kkaya674/EE463-TermProject/Demo/20220121_111625.jpg

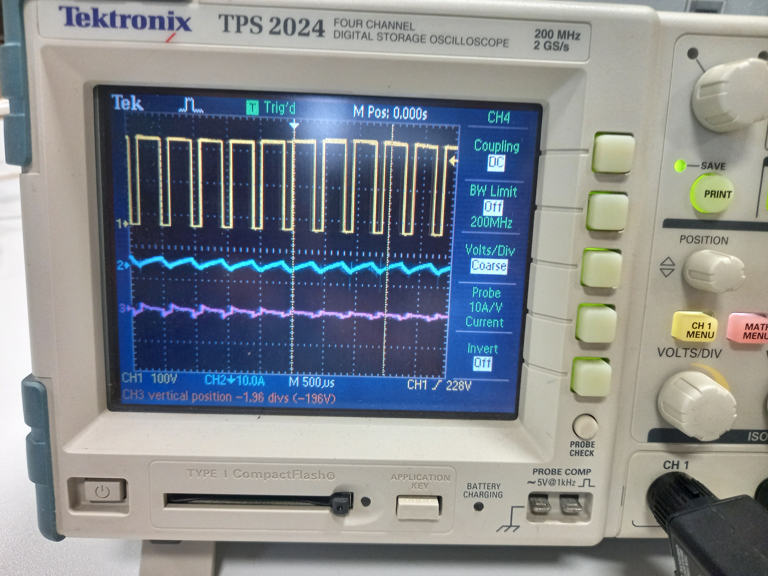
Demo/20220121_111625.jpg
