kkaya674/EE463-TermProject/README.md

# EE463-TermProject
ENJIN DRIVERS: 
Tuğçe Şevval Kaya,
Zehra Güneş, 
Kubilay Kaya

Youtube Video Link : https://www.youtube.com/watch?v=VgHXCVj92XA
