kkaya674/EE463-TermProject/Reports/TermProject Report.docx

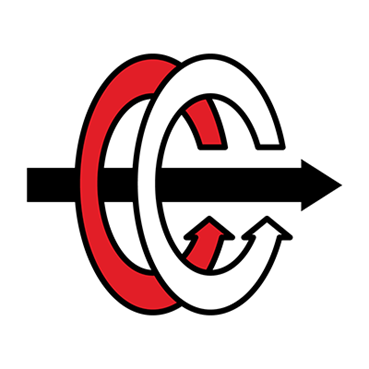
[picture p3: figure]

MIDDLE EAST TECHNICAL UNIVERSITY

DEPARTMENT OF ELECTRICAL & ELECTRONICS ENGINEERING

EE 463- Static Power Conversion I - Hardware Project

DC Motor Drive

Simulation Report

Prepared for Assoc. Prof. Ozan KEYSAN

Tuğçe Şevval Kaya -

Zehra Güneş - 2232023

Kubilay Kaya - 2304905

Table of Contents

Introduction & Specification

# Topology Selection

## Thyristor Rectifiers

### Single Phase Thyristor Rectifiers

#### Advantages

- It contains less circuit elements compared to other topologies.
- Less cost.

#### Disadvantages

- High Ripple Voltage.
- Needs a suitable firing angle. Therefore, controlling the thyristor rectifier is harder than the diode rectifier & buck converter topology.
- In order to minimize the ripple voltage, larger capacitors are needed. Therefore, it leads to unnecessary costs.
- Its true power factor is too small compared to the other topologies since it has higher THD value. THD of input current is not suitable for our applications.
- It is not proper for high voltages.

### Three Phase Thyristor Rectifiers

#### Advantages

- It has less ripple voltage compared to single phase thyristor rectifiers.
- Since the ripple voltage is smaller, the average DC voltage is higher than the single-phase thyristor rectifier.
- It needs a smaller capacitor since the ripple voltage is less.
- Can reach 1.35 times of input line-line voltage.

#### Disadvantages

- More complicated structure.
- The gate control is harder than the single-phase thyristor rectifier.
- It needs more circuit equipment; therefore cost is higher.
- The power factor is still small due to the THD of the input current.

## Three Phase Diode Rectifier & Buck Converters

#### Advantages

- Controlling is easy compared to thyristor rectifiers.
- Using a bridge rectifier, it is more compact.
- Can reach 1.35 times of input line-line voltage.

#### Disadvantages

- In order to minimize inrush current, an inductor should be added to the circuit.
- Its cost is high since the buck converter is the switching equipment. (IGBS, MOSFET etc.)

## Why Diode Rectifier & Buck Converters

We choose 3-phase diode rectifier and buck converter topology in order to drive the DC machine because of these reasons:

- Constructing a diode rectifier is easier than other topologies.
- Constructing a buck converter is cheaper than other topologies since the DC machine already provides the necessary inductor, capacitor, and resistors.
- By using a 555 timer, we can control the buck converter’s switch gate. This is more harder in thyristor rectifiers.

# Analytical Calculation

## Buck Converter Design

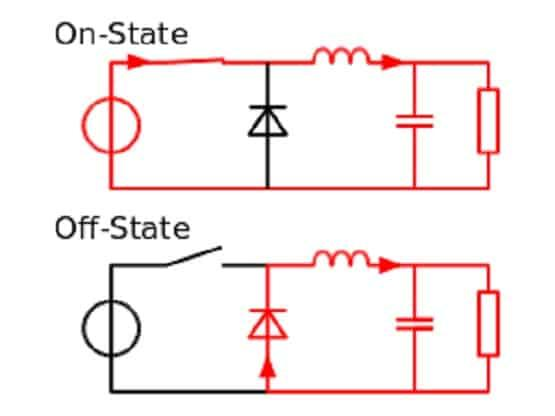
[picture p4: figure]
Buck Converter Nedir, Nasıl Çalışır? - Mühendis Beyinler

Basic circuit model of a buck converter at on and off states in CCM

#### On state

V_d -V_o = V_L and i_c =i_L -(V_o)/R

#### Off state

V_L = -V_o and i_c = -(V_o)/R

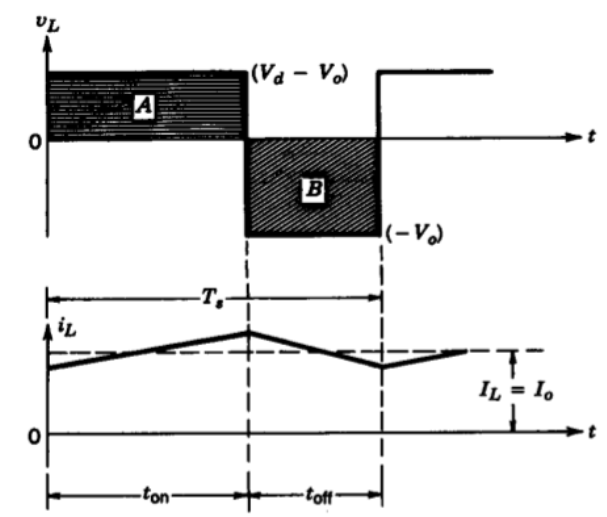
[picture p5: figure]

Voltage and current waveform models of the buck converter

A(ON) (V_(in) -V_o )DT_S =B(OFF) V_o (1-D)T_S

V_(in) D- V_O D=V_o -V_o D

V_o = V_(in) D

0≤ V_o ≤ V_(in) and I_o =(I_d)/D

Since our motor input (Vo) should be smaller than given 180 V maximum level,

180> V_(in) D

Due to nonideal performance conditions, having 1 or 0 duty cycle is not easy to satisfy. Thus,

0.2≤D≤0.8 will be much more valid

Hence, we can define a condition for the input voltage of the buck converter (V_(in) ) as

180/D> V_(in) →180/0.8> V_(in) → V_(in) <225 V

Throughout the function of the buck converter, we also estimated the minimum inductance value to stay in

Continuous Current Mode

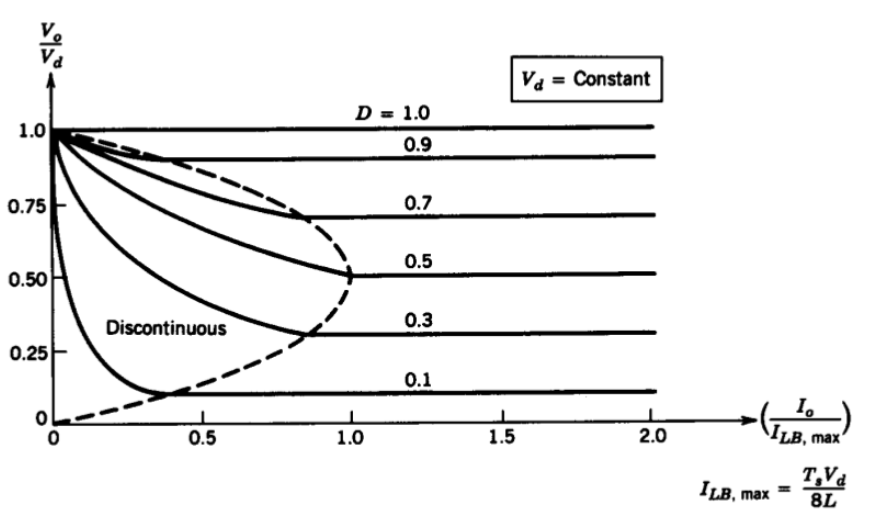
[picture p6: figure]

Output voltage and current relations at Continuous and Discontinuous Conduction Modes

As it can be observed, the critical current value occurs when D = 0.5

Assuming I_(LB) = (i_(L,peak))/2 as I_(LB) = (t_(ON) (V_d -V_o ))/(2L) with t_(ON) =DT_S

Then I_(LB) = (DT_S (V_d -V_o ))/(2L)→ Inserting D=0.5 I_(LB,MAX) = (T_S V_d)/(8L)=(V_d)/(8Lf_S)

also V_o =DV_d

I_(LB) = (DT_S (1-D)V_d)/(2L)= (T_S (1-D)V_O)/(2L) = ((1-D)V_O)/(2Lf_S)

thus, minimum inductance for CCM: L_(min) = ((1-D)V_O)/(2I_(LB) f_S)= ((1-D)Z_(load))/(2f_S)

Foer our case D = 0.5, by given armature impedance of the motor and assuming our frequency range 1-5 kHz it is obtained that

L_(min) = (Z_(load))/(4f_S)≈(0.8Ω)/(4*1000)=0.2 mH

and I_(LB,MAX) =(V_d)/(8Lf_S)=(225 V)/(8*0.2mH*1kHz)<given motor current data=23.4 A

Meaning that throughout our duty cycle choices, even if we do not implement an additional inductor since there is already an inertial inductance of the motor, which is higher than 0.2 mH, we will be in a safe zone for the continuous conduction mode.

#### Voltage Ripple for the Buck Converter

∆Q= ((∆I_L)/2*(T_S)/2)/2=(T_S (∆I_L ))/8

also ∆V_o = (∆Q)/C→ ∆V_o = (T_S (∆I_L ))/(8C)

By using off time ratio (1-D) it is obtained that

∆I_L = (V_o (1-D)T_S)/L since i_L =1/L∫ V_L dt

Then we get ∆V_o = (T_S V_o (1-D)T_S)/(8LC)

and ripple→ (∆V_o)/(V_o)=((1-D)T_S^2)/(8LC)= ((1-D))/(8LCf_S^2)

For worst case scenario, by taking as D=0.2, f_S =1kHz, L=12. 5 mH by only armature

Ripple ≈ 0.8/(8*12.5mH*1000^2 *C)=(8 x 10^(-6))/C

At this point, increasing the frequency or implementing an extremely high capacitor would have been expected as possible solutions. However, increasing the frequency means also increasing the switching losses, which can be found in the thermal analysis part, and it can disturb the thermal limit of our components. Moreover, a small capacitance will not be enough to obtain a reasonable ripple range, much higher value can balance that, yet this will cause higher cost and sizes in our design which may not be applicable under experimental conditions. Thus, it is currently considered that the internal capacitance of the motor will satisfy our conditions. Besides, if it seems necessary during test periods, by choosing 3.3 µF capacitor will be placed.

Hence the ripple is obtained as

(8 x 10^(-6))/C→(8 x 10^(-6))/(3.3 x 10^(-6)) ≅2.42 V

which can be accepted as small in the range of our motor input.

## Rectifier Design

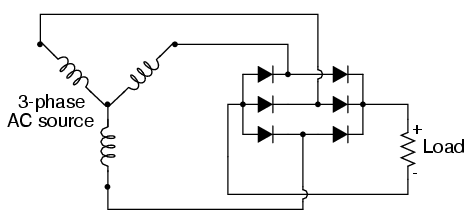
[picture p7: figure]
LM74670-SQEVM: Three phase bridge rectifier design contains large spikes on output - Power management forum - Power management - TI E2E support forums

The circuit connection model of three phase full bridge rectifier design

As it was found previously on the buck converter design part that

V_(in) <225 V for the motor

Since the input voltage of the buck converter is supplied by the output voltage of the rectifier,

V_(out) <225 V for the rectifier

By Yn configuration, the necessary input voltage for the rectifier can be estimated as

V_(out) = (3√2)/πV_(l-l) <225 V→V_(l-l) <(225*π)/(3√2) ≅166.6 V

and V_(in,phase) =166.6/(√3) V

## 555 Timer Calculations

Basic 555 timer structure,

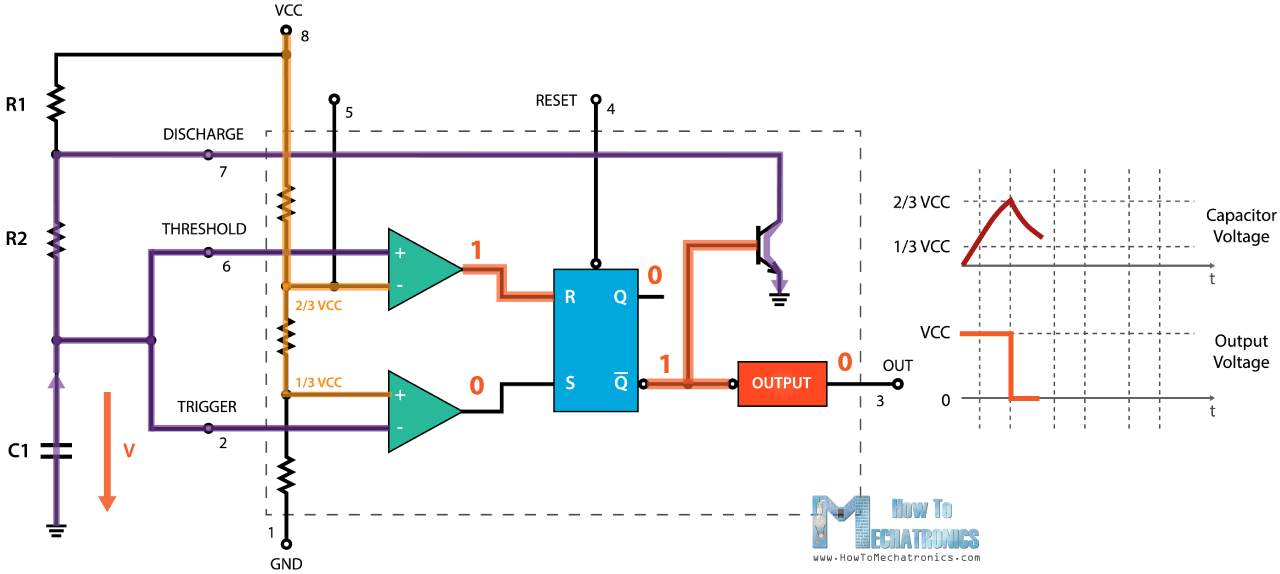
[picture p8: figure]

Formulas,

T_(on) =0.693*(R_1 +R_2 )*C_1

T_(of) =0.693*R_2 *C_1

T_(total) =0.693*(R_1 +2R_2 )*C_1

f=1/(0.693*(R_1 +2R_2 )*C_1 )

PWM(%)=(T_(on))/(T_(total))=((R_1 +R_2 ))/((R_1 +2R_2 ))*100

In order to create adjustable PWM, we add this configuration to the diodes and POTs via the charging and discharging paths.

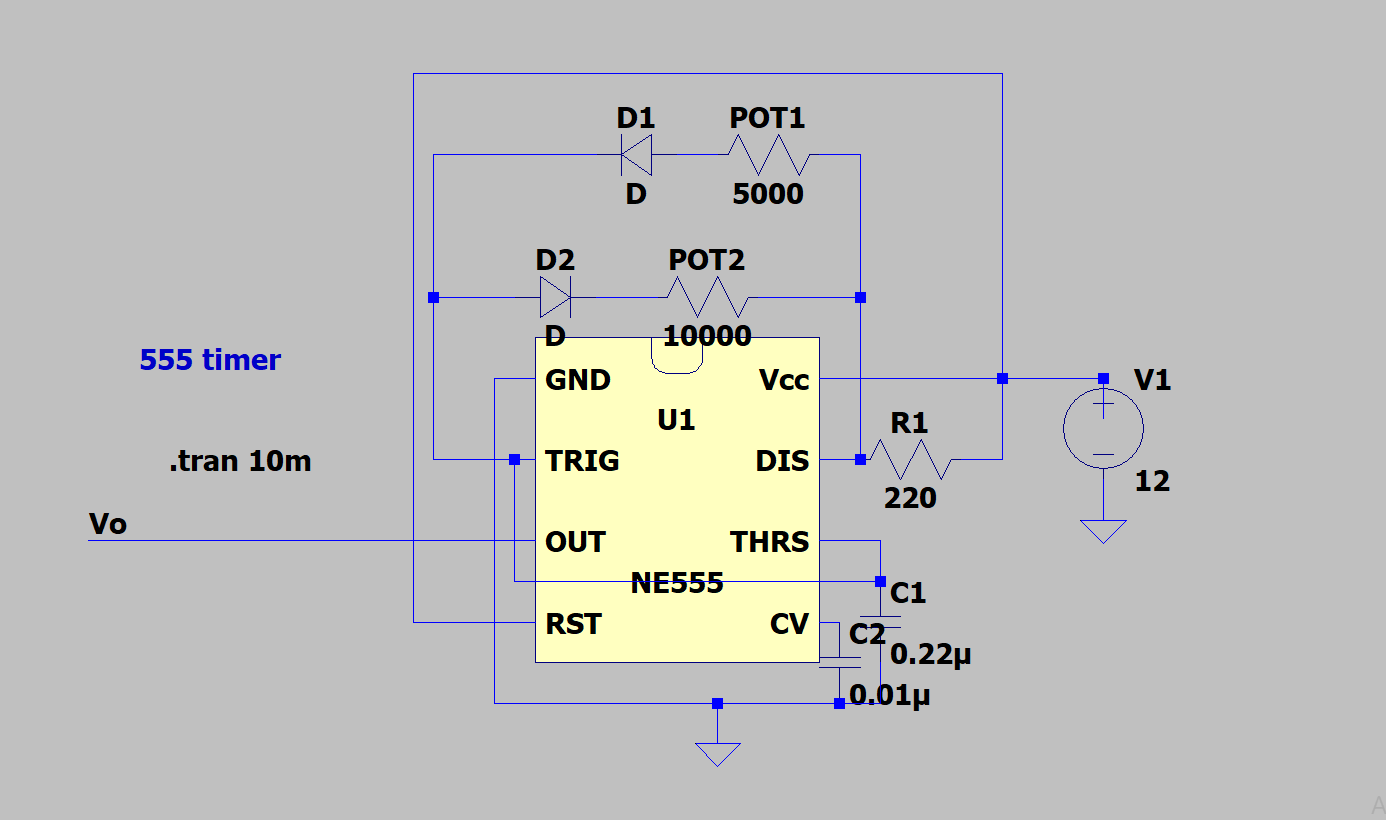
[picture p9: figure]

Calculations,

T_(on) =0.693*(R_(POT1) +R_1 )*C_1

T_(of) =0.693*(R_(POT2) +R_1 )*C_1

T_(total) =0.693*(R_(POT1) +R_(POT2) +2R_1 )*C_1

f=1/(0.693*(R_(POT1) +R_(POT2) +2R_1 )*C_1 )

PWM(%)=(T_(on))/(T_(total))=(R_(POT1) +R_1)/(R_(POT1) +R_(POT2) +2R_1)*100

We have used 5kΩ and 10kΩ resistance respectively for POT1 and POT2. In real, POT1 is changing between 1.6Ω and 4.8k Ω and POT2 is changing between 2.8Ω and 9.6kΩ. Then,

PWM maximum,

T_(on) =0.693*(4.8kΩ+220Ω)*0.22*10^(-6) =0.795ms

T_(of) =0.693*(2.8+220Ω)*0.22*10^(-6) =0.034ms

f=1.19kHz

PWM(%)= 98%

PWM minimum,

T_(on) =0.693*(1.6Ω+220Ω)*0.22*10^(-6) =0.0337ms

T_(of) =0.693*(4.8k+220Ω)*0.22*10^(-6) =1.558ms

f=628Hz

PWM(%)= 2.1%

Although we could reach these PWM values, we have to stay away from the boundary points of PWM. This is because at the near 0% and 100% PWM values, the switch (IGBT) cannot be operated properly since it has a switching time interval of ON and OFF times, PWM is not enough to compensate for it. Therefore, we changed R1 with 1kΩ and we have adjusted PWM between 17% and 85%. By the same steps,

PWM maximum,

T_(on) =0.884ms

T_(on) =0.152ms

f=965Hz

PWM(%)= 85%

PWM minimum,

T_(on) =0.152ms

T_(on) =0.884ms

f=965Hz

PWM(%)= 17%

As seen from obtained results, the operating frequency is around 1kHz, so we decide to use IGBT as a switch. The performance of IGBT is greater than MOSFETs and other switches at low frequencies. Also, the current rating of IGBTs can reach up to 1kA.

# Simulation

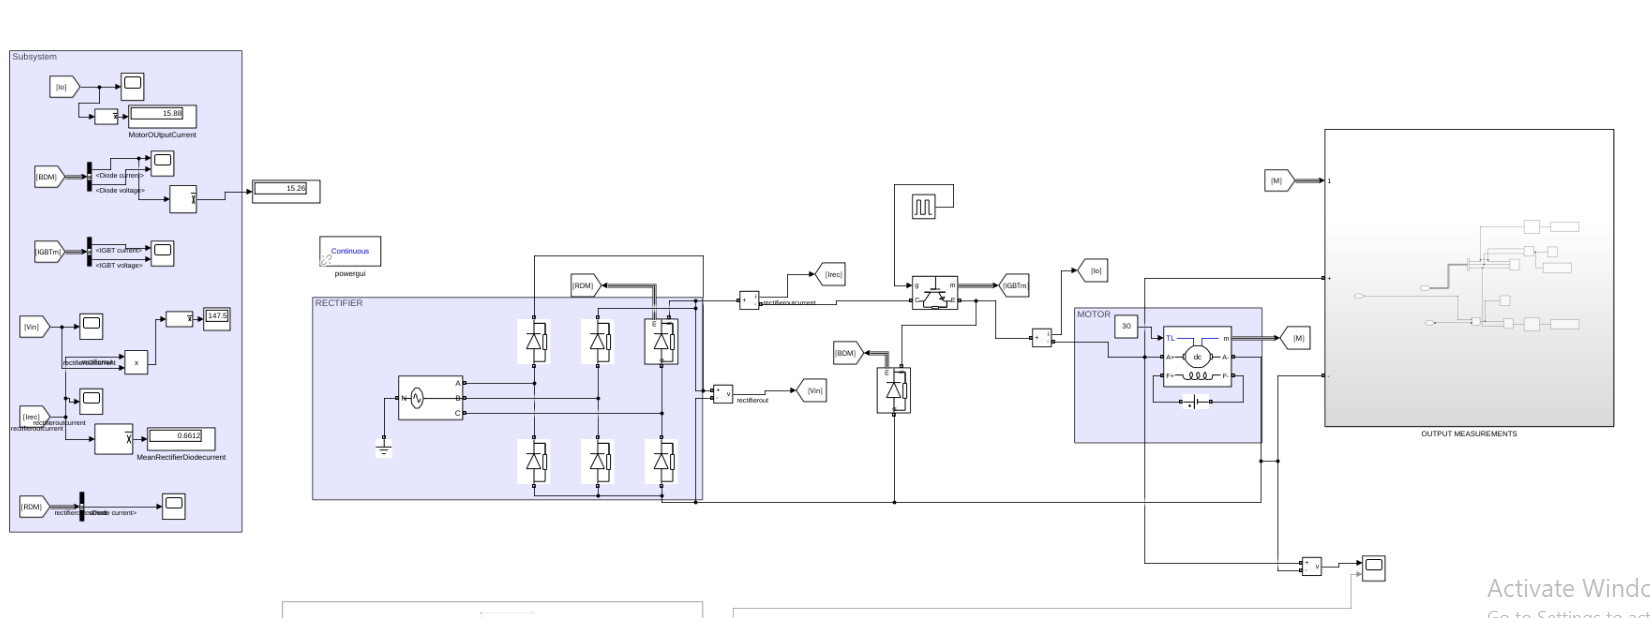
[picture p10: figure]

## 3-Phase Diode Rectifier:

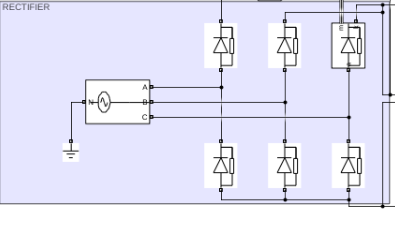
[picture p11: figure]

Rectifier diode current and voltage waveforms,

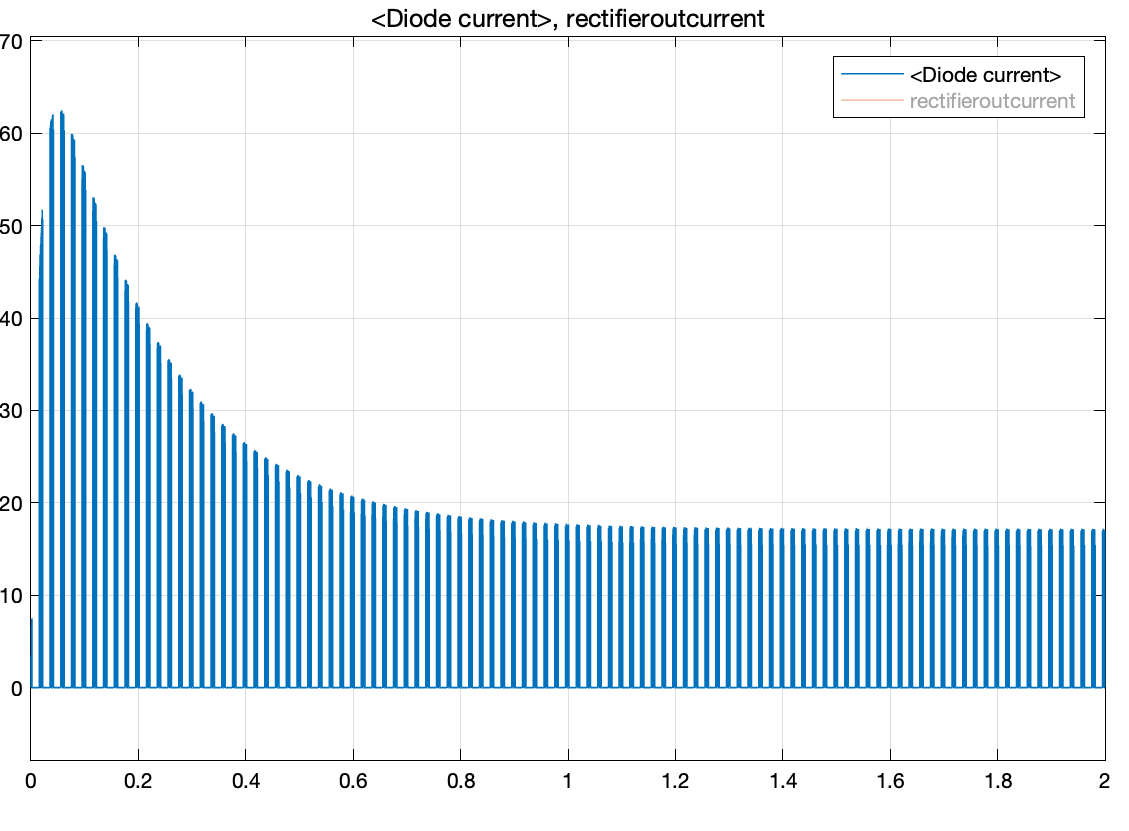
[picture p12: figure]

The graph which can be seen above shows the diode’s starting current if we set the initial duty cycle as 0.2. However, since we don’t know the line impedance, we didn’t add any value to our simulation. Therefore, we expect that less inrush current will be measured in laboratory conditions. Another factor of high starting current is the stationary motor. When the motor is stationary, armature voltage is equal to zero. Then, when we supply voltage to the DC machine, the high current is passing thoruogh armatures. This becomes very problematic since it can damage the circuit. Therefore, we still try to stabilize the armature current for soft-starting.

## A555 Controller

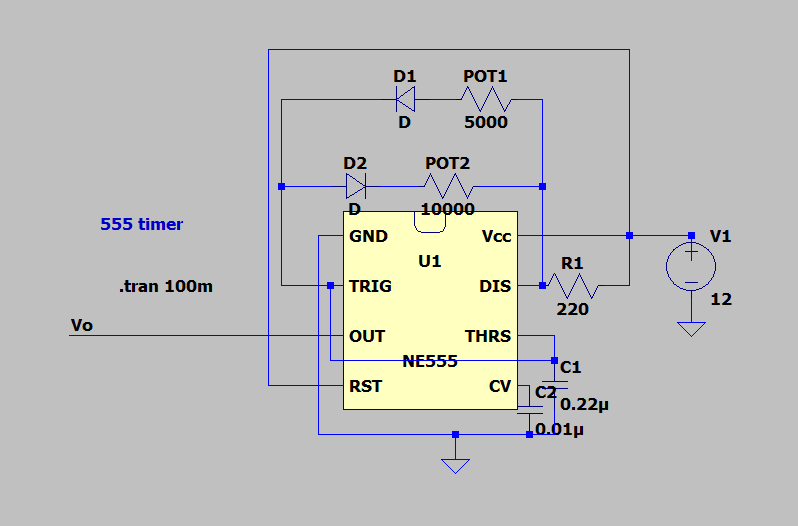
[picture p13: figure]

Maximum duty cycle case,

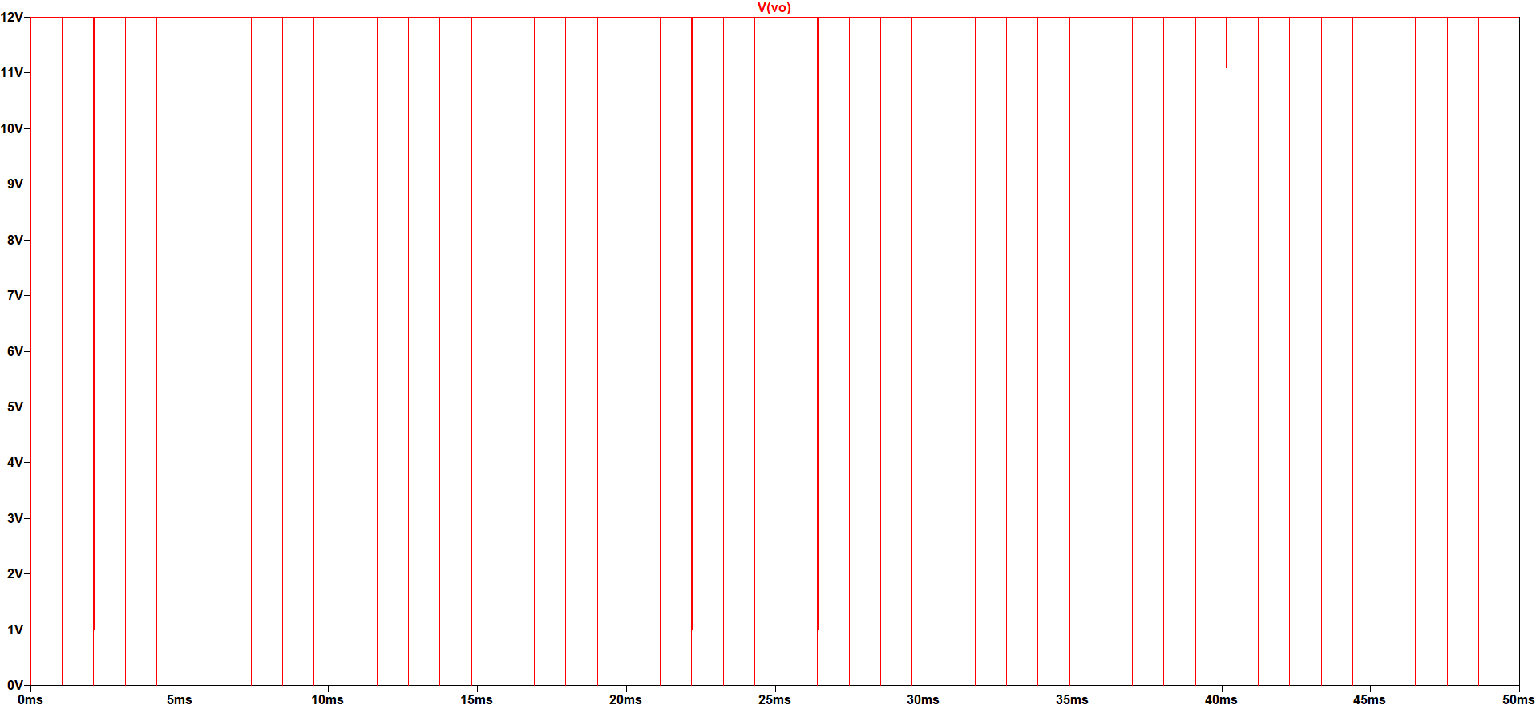
[picture p14: figure]

Minimum duty cycle case,

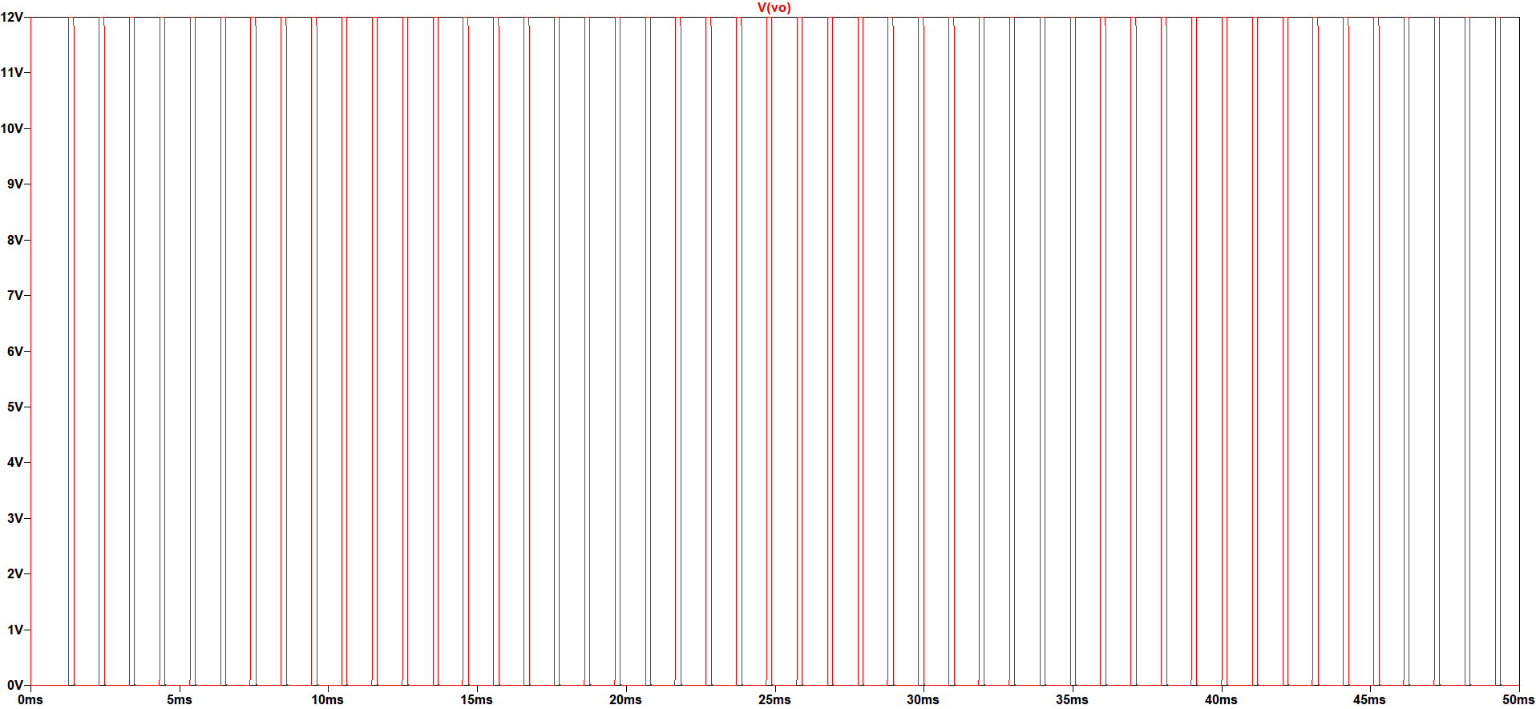
[picture p15: figure]

According to our research, we see that the most convenient way to control the buck converter is using the ASTABLE 555 Timer circuit. An Astable timer can be controlled just by using POTs.

The most crucial advantage of this timer is changing duty cycle easily. However, the frequency changes according to the resistor values that we change. Therefore, it may be a disadvantage. On the other hand, we are using an IGBT for buck converter and it is proper for the 1-5kHz interval. Therefore, we calculated the resistance of the timer to work between these frequency intervals.

In the timer circuit above, R1 & R2 values determine the frequency and the duty cycle of the circuit. We are planning to change both R1 & R2 during our project. The related formulations and description can be seen in the “Analytical Calculation” part.

## Buck Converter

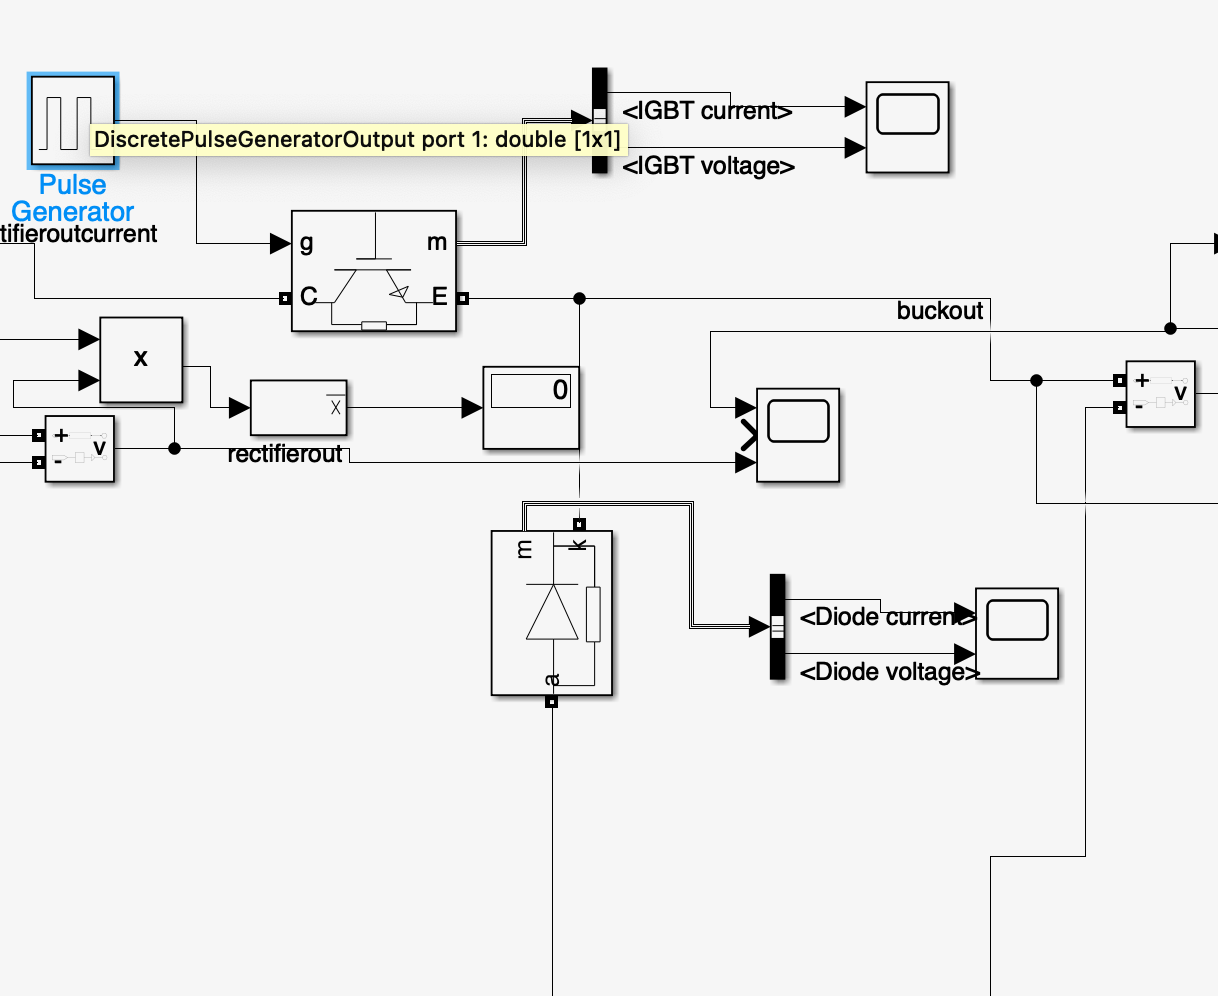
[picture p16: figure]

Here we see the buck converter part. As can be seen, we didn’t connect any capacitor, inductor, and resistance because the DC motor already provides these components’ characteristics. On the other hand, in case of any necessities, we also bought some capacitors to provide better dc voltage at the input terminal of the DC machine.

#### IGBT

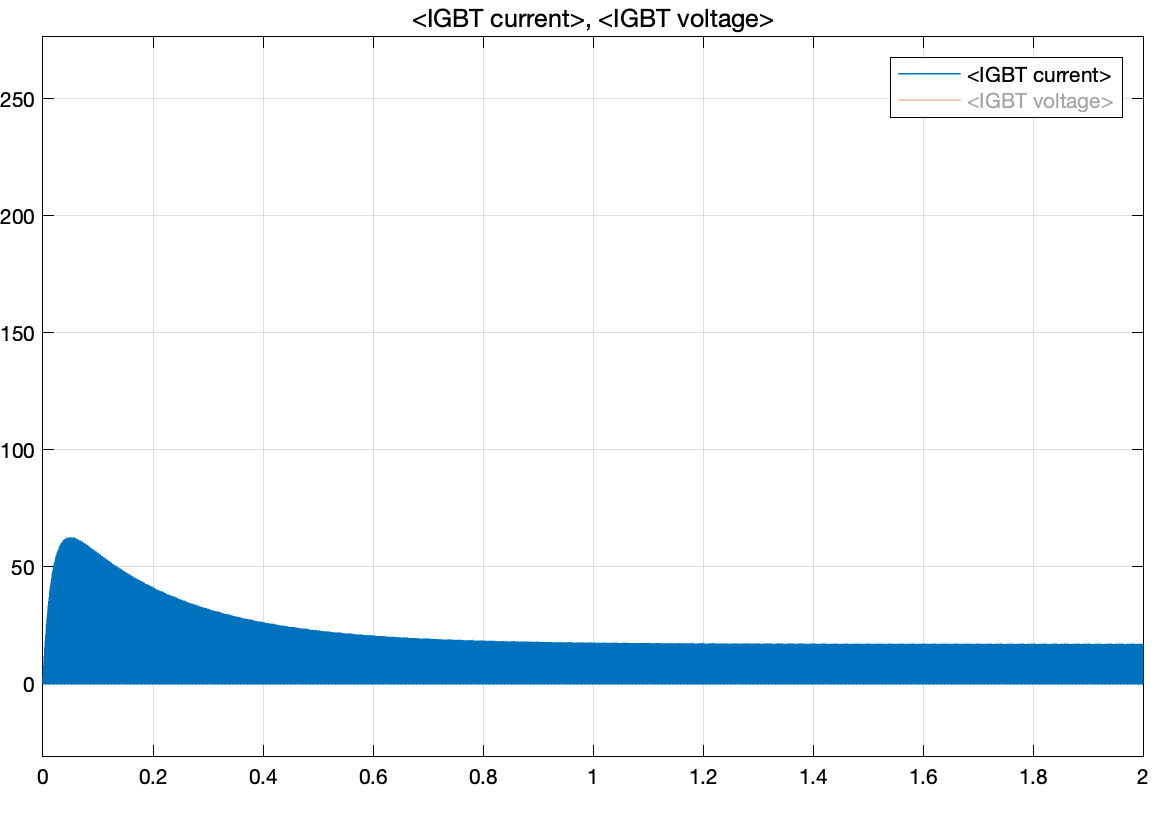
[picture p17: figure]
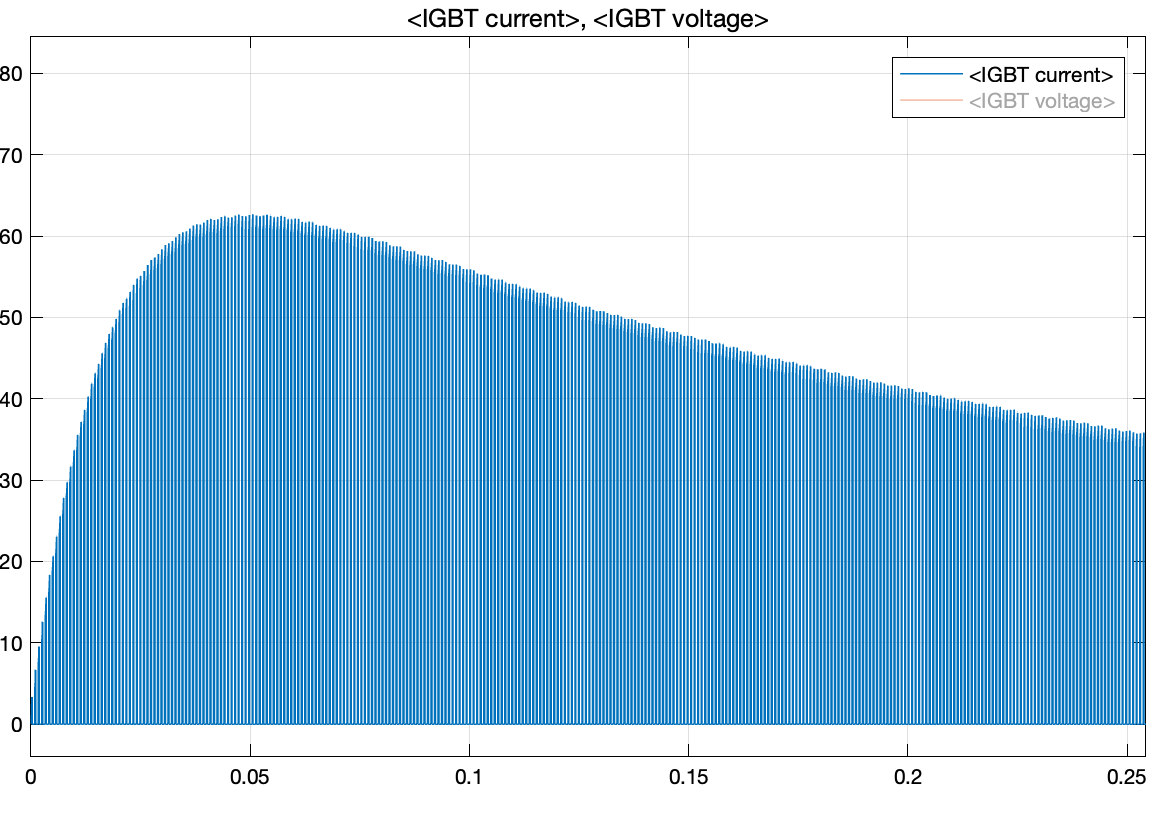
[picture p18: figure]
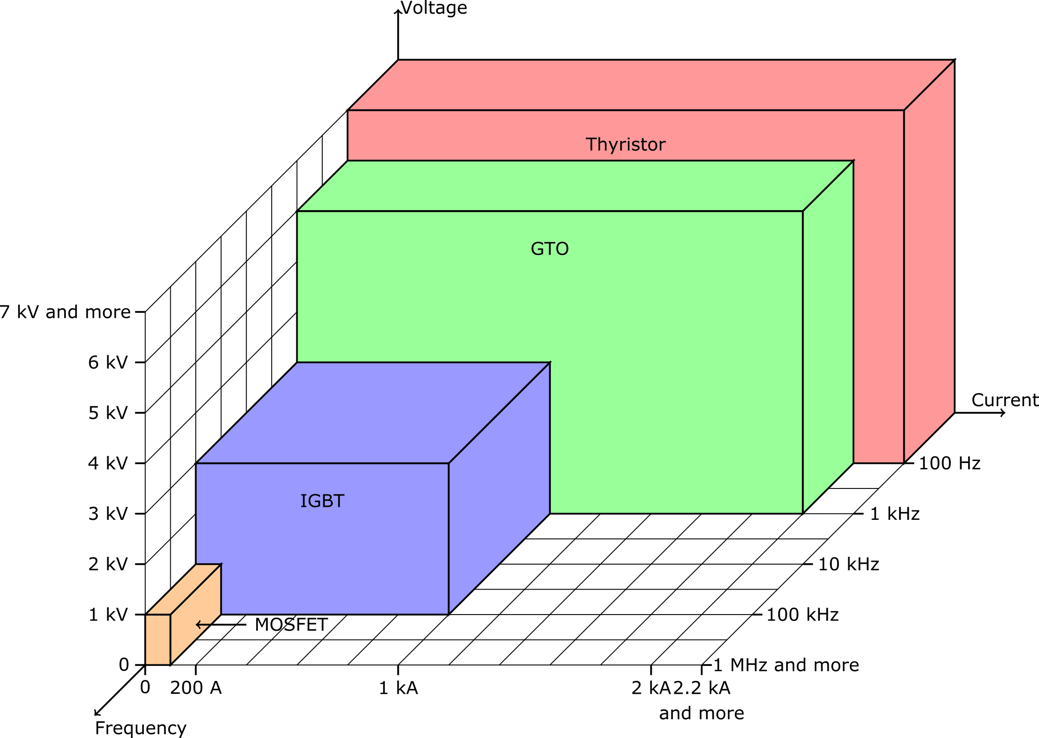
[picture p19: figure]

In our design, we did a selection between MOSFET and IGBT. Since IGBT can work at low frequency and operates at high current values, we choose the IGBT as a switching device. Above, the steady state and starting currents of IGBT for 0.2 duty cycle can be seen. As can be seen, the starting current is relatively high. However, as mentioned in previous parts, we didn’t add any inductor to the source side. Therefore, the inrush current at start up occurs. Also, in this case, the motor’s initial speed is zero. During the demo, since we set an initial voltage by using variac, we expect that this high current will not occur, and we will not observe any problem.

#### Gate Driver

By using a gate driver we have tried to operate IGBT properly without exceeding rating values. When we do not use a gate driver, the gate-emitter value can reach very high values. However, the rating value of gate-emitteer voltage is about 20V for most IGBTs. Therfore, the gate driver provides the same duty cycle to the IGBT by keeping it in a safe region.

Design schematic of gate driver,

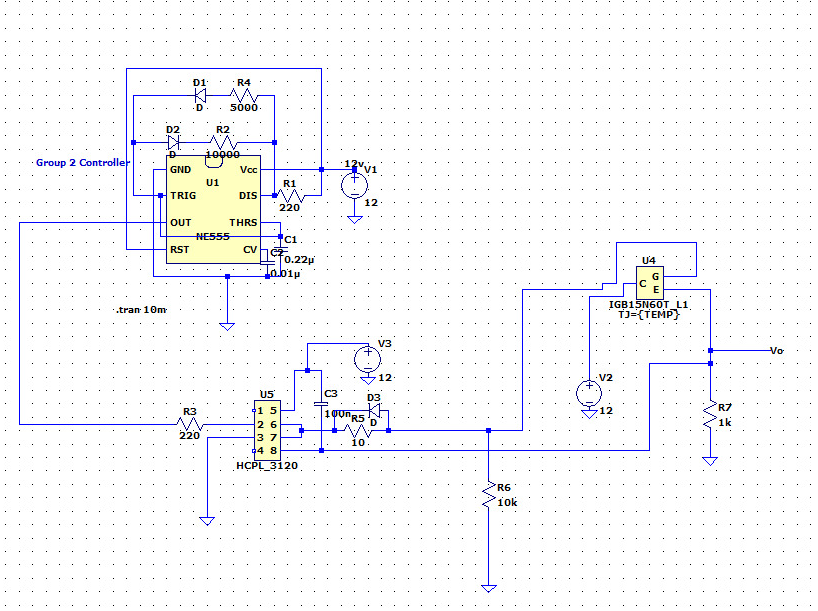
[picture p20: figure]

Output pwm obtained from 555 timer,

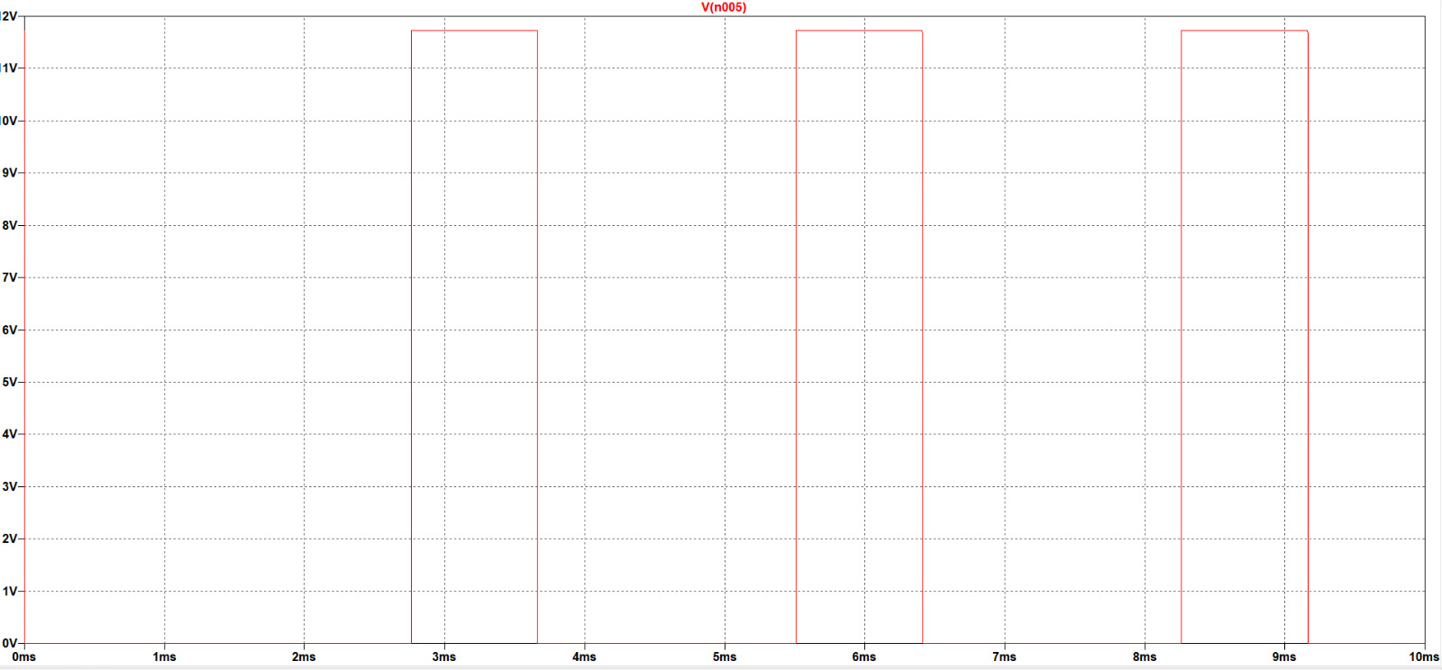
[picture p21: figure]

Output emitter voltage of IGBT,

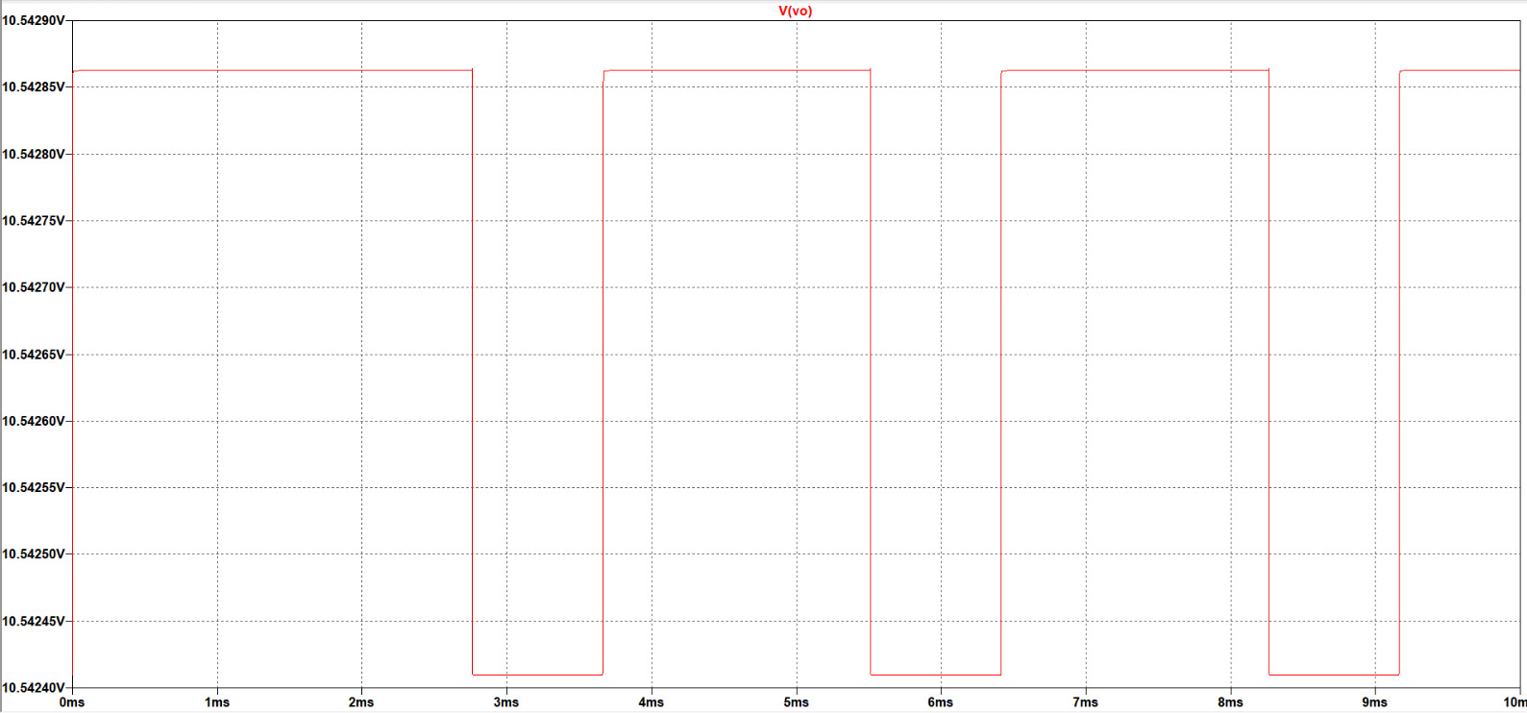
[picture p22: figure]

As seen from the figures, output voltage is a complement of PWM. In order to solve this problem, we decided to add the transistor to the input of the gate driver(pin 1 and 2). The transistor behaves like an inverter and when PWM is high, it gives output low and vice versa. Therefore, input PWM is inverted by transistor and output emitter voltage has a similar shape with the PWM obtained by 555 timer.

#### Buck-Converter Diode

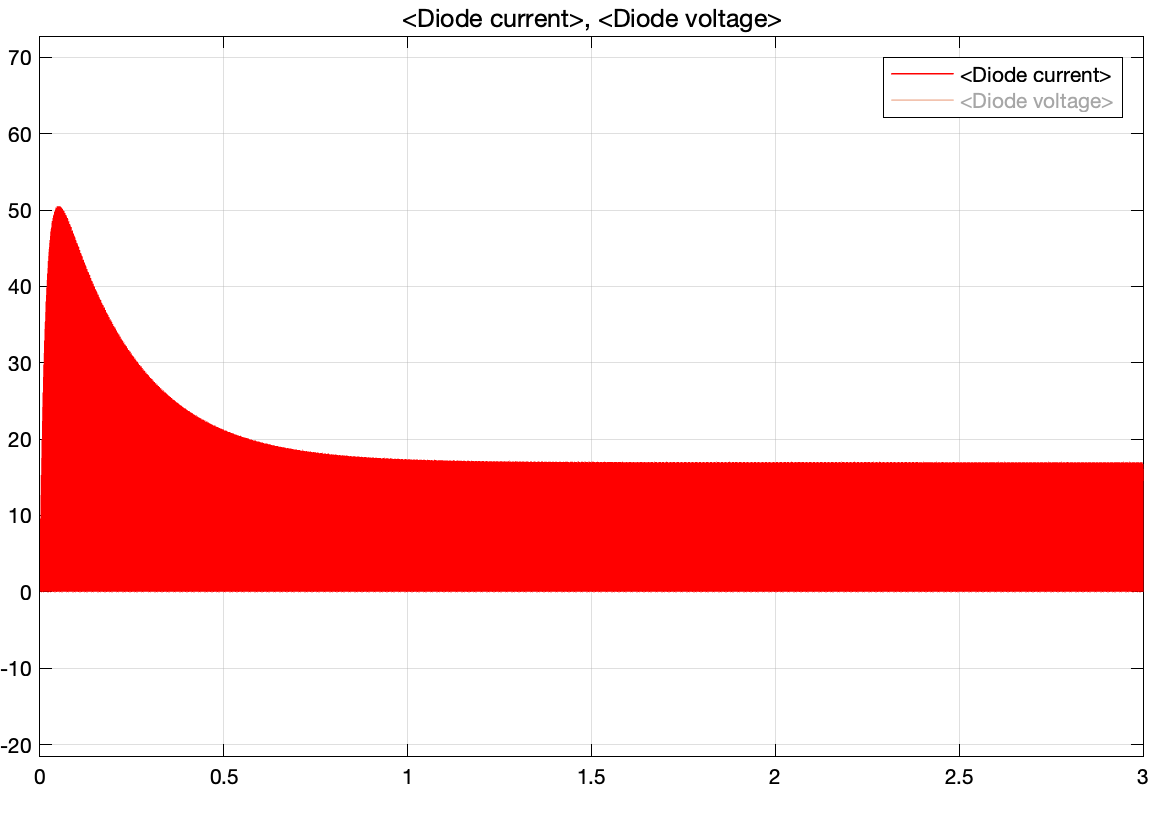
[picture p23: figure]
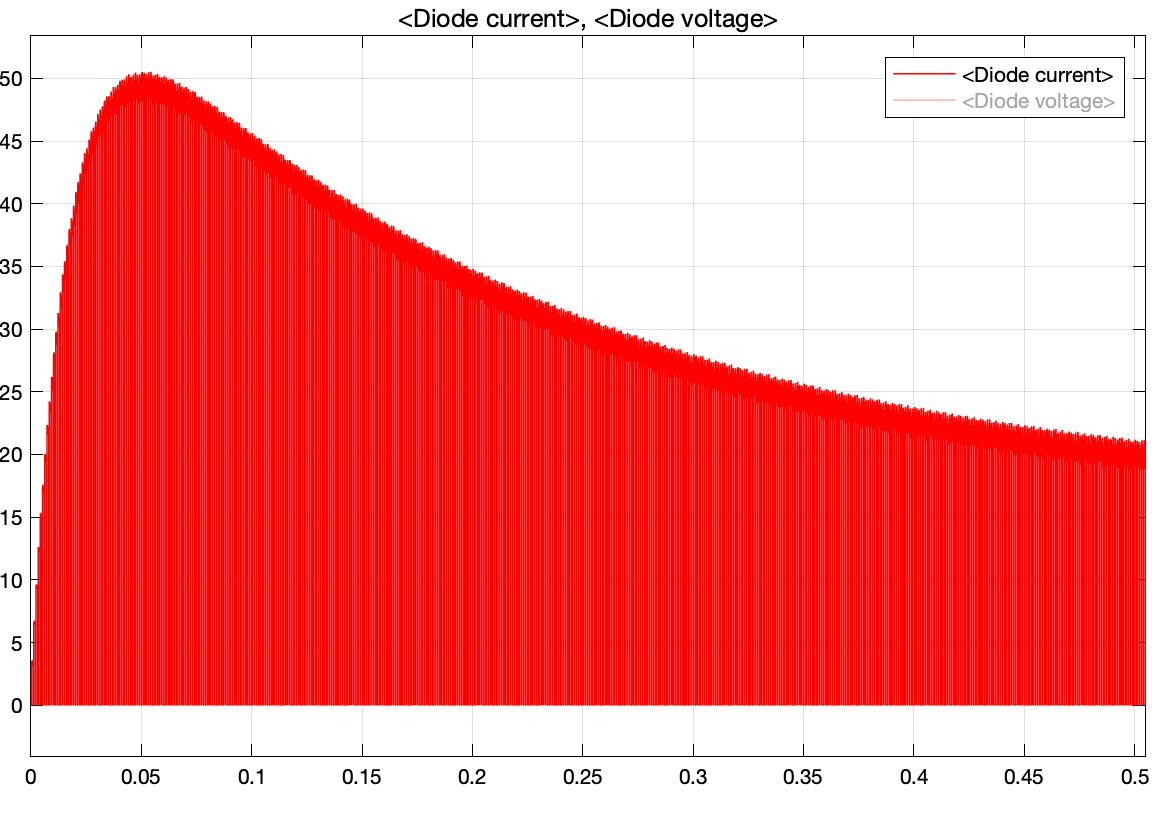
[picture p24: figure]

When the duty cycle of a buck converter is low, the mean current passing through the diode is high.). We measure the mean current is about 20A at duty cycle 20%. Therefore, we have choosen a diode accordingly. The details can be seen at the component selection part.

## DC Machine:

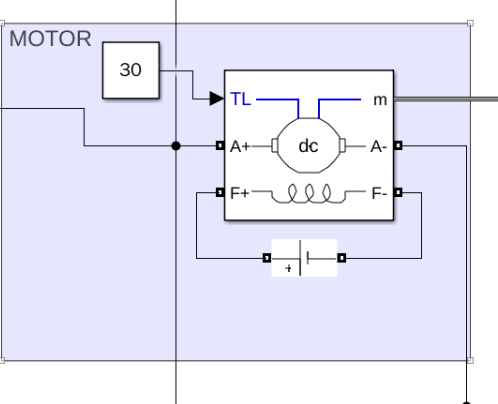
[picture p25: figure]

### For 0.2 Duty Cycle Output Values

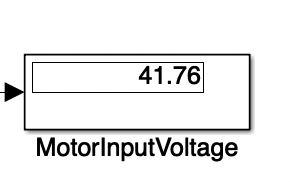
[picture p26: figure]
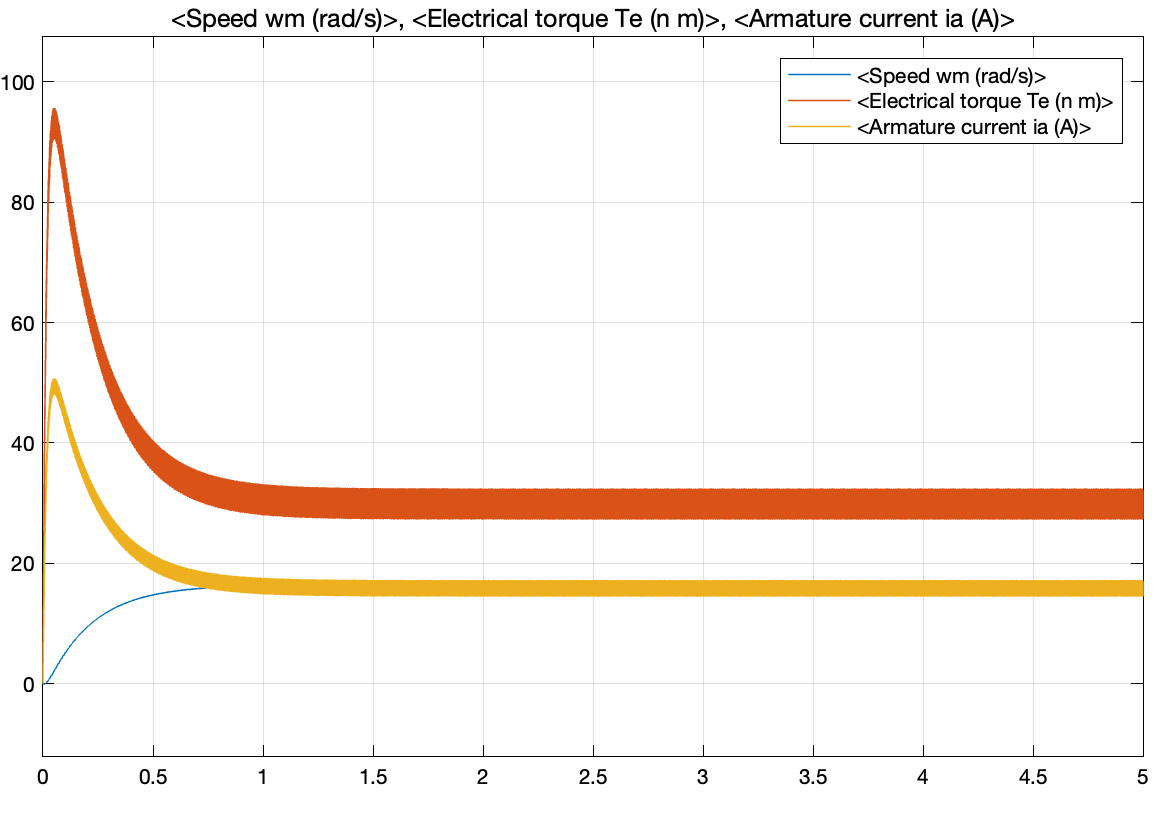
[picture p27: figure]
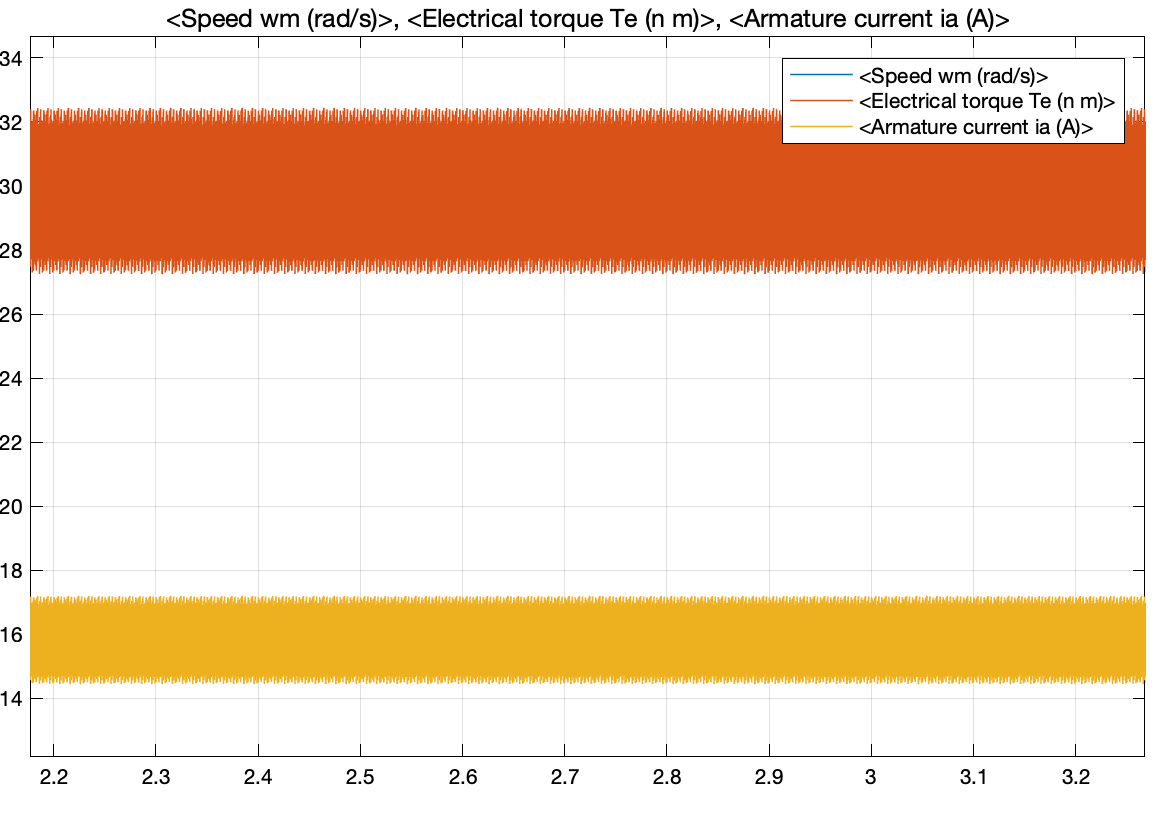
[picture p28: figure]
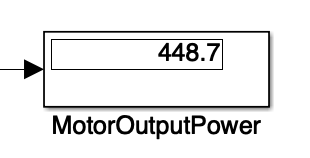
[picture p29: figure]

### For 0.8 Duty Cycle Output Values

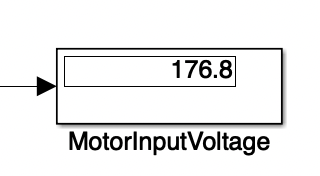
[picture p30: figure]
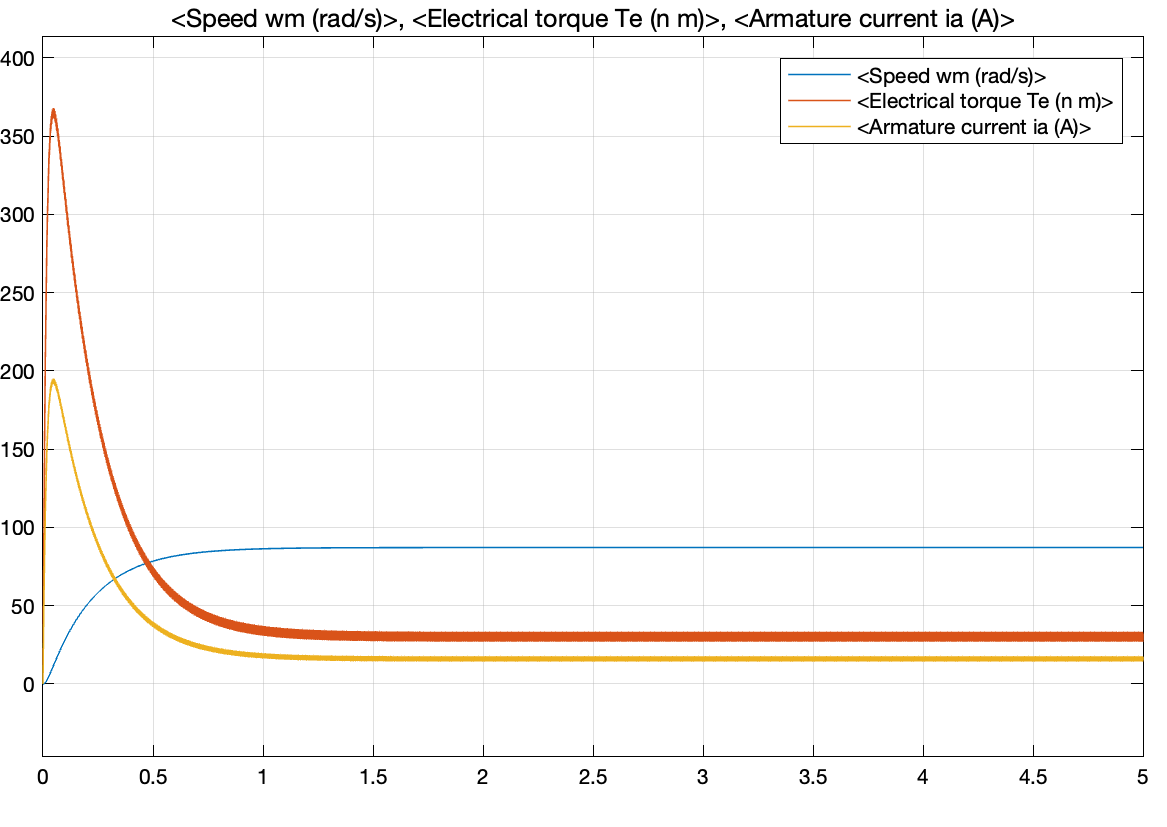
[picture p31: figure]
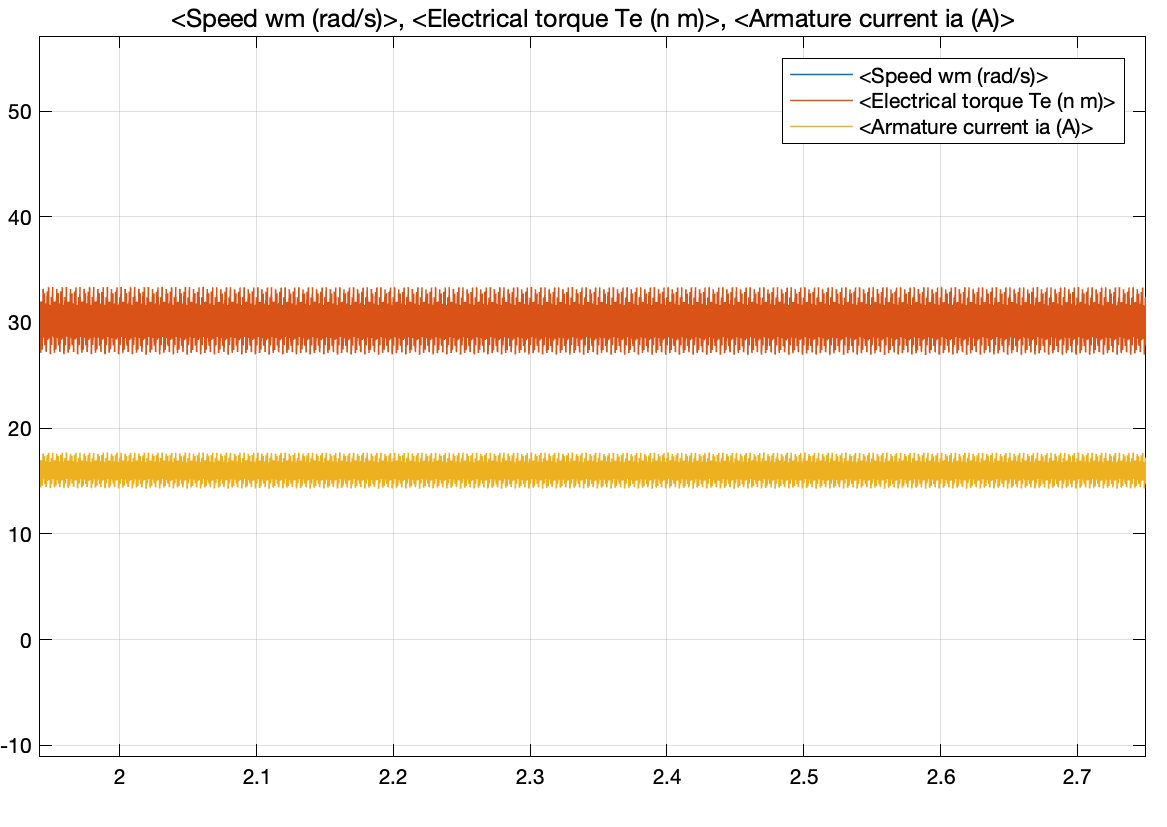
[picture p32: figure]
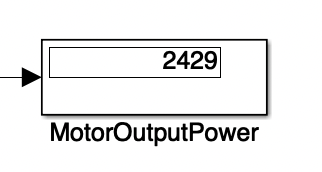
[picture p33: figure]

Since we don’t want to reach the edges of 0 and 1, we determined the use 0.2-0.8 duty cycle values at min and max. Therefore, we added the related simulation results for the DC machine as can be seen above. Here, we see that only speed is changing when duty cycle is changed.The steady current is about 16A and this value meets our requirements. Also, we see a high inrush current for the 0.8 duty cycle. Since the motor speed is zero at the start-up, this inrush current is normal. In our demo day, we are allowed to do soft start using variac. Therefore, we expect that there is no high inrush currents observed.

## Additional Simulation

We also obtain the duty-cycle vs. Torque-Current-Speed graph. If we will change the duty cycle %15 at each second, the Torque, Current, Speed vs time graph can be observed like that:

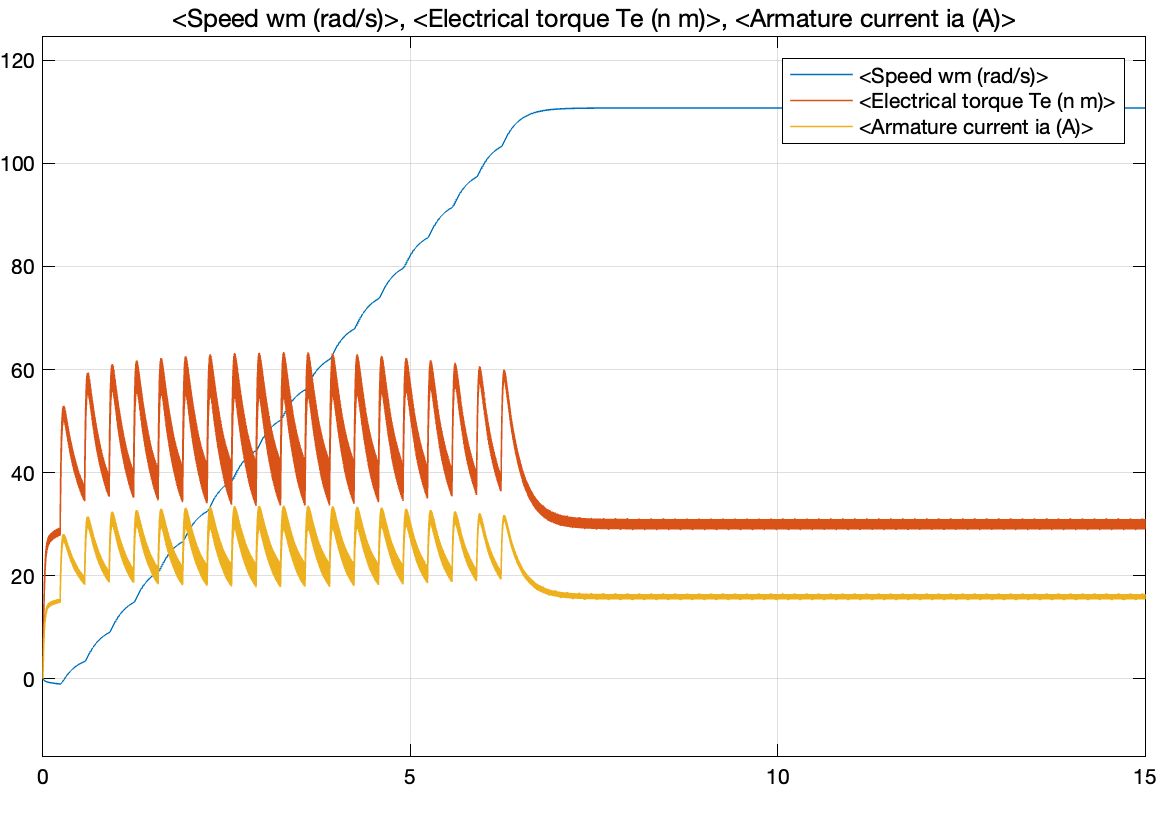
[picture p34: figure]

# Component Selection

Component | Manufacturer Number | Quantity | Price(₺) | Total Price(₺)
Three phase bridge diode | SKBPC5016 | 1 | 38.5 | 38.5
Timer | NE555P DNSX19 | 1 | 2.6 | 2.6
IGBT | IXGH24N60C4D1 | 1 | 36.45 | 36.45
Diode | DSEI30-06A | 1 | 40.03 | 40.03
Transistor | BC308B | 1 | 1.33 | 1.33
Gate Driver | HCPL-3120 | 1 | 22.67 | 22.67
Fuses(30A 6*30mm ceramic fuse ) | - | 5 | 2.66 | 13.33
Capacitor(3.3uF 50V ceramic capacitor) | - | 1 | 0.888 | 0.888
Capacitor(220nF 630Vdc) | - | 1 | 1.13 | 1.13
Capacitor(10nF 50V ceramic capacitor) | - | 1 | 0.752 | 0

## Rectifier Diode

SKBPC5016 50A 1600V Three phase bridge diode

PEAK REPETITIVE REVERSE VOLTAGE | 1600V
AVERAGE RECTIFIED FORWARD CURRENT | 50A
PEAK REVERSE CURRENT | 10uA
NON-REPETITIVE PEAK SURGE CURRENT | 500A
FORWARD VOLTAGE(IFM=17A) | 1.2V

According to our simulations and calculations, we see that we need a diode which can carry at least 30A. Since three-phase bridge diodes are cheaper than 6 diodes and they have a smaller size, we choose 3phase bridge rectifier diode. It can carry 50A for 1600V.

## Timer

NE555P DNSX19

Since we generate a PWM by using only capacitors and resistors, we choose the NE555 Timer. This timer can generate PWM from microsecond to hour intervals. We will generate 1-5kHz square waves in our circuit.

## IGBT

IXGH24N60C4D1 N Channel IGBT Transistor 30A 600V

COLLECTOR-EMITTER VOLTAGE | 600V
GATE-EMITTER VOLTAGE | +/- 20V
COLLECTOR CURRENT | 49A @ 25°
POWER DISSAPATION | 187W
OPERATING TEMPERATURE | -55° / +150°

We calculated and measured that we will use at most 25A in our circuit at the steady state. Since the range of MOSFETs are not enough, we will use IGBT in our circuits. In our research, we couldn’t find an IGBT that has higher current capability than IXGH24N60C4D1. Therefore, we decided to use this IGBT which also exists in the laboratory.

## Freewheeling Diode

DSEI30-06A 37A 600V 35ns Ultrafast Diode

RATED REPETITIVE REVERSE VOLTAGE | 600V
AVERAGE RECTIFIED FORWARD CURRENT | 37A
MAXIMUM REVERSE CURRENT | 50uA
FORWARD VOLTAGE | 1.6V
REVERSE RECOVERY TIME | 50ns

For low duty cycles, the current through the buck converter’s diode increases. Therefore, we have chosen the diode with the current rate accordingly. Also, since its recovery time is small, we eliminate the switching losses.

## Capacitor & Resistor

We bought different capacitors and resistors for different purposes. Since we will use these capacitors in our controller, we don’t focus on their voltage and power ratings. However, as we mentioned in previous parts, we bought some capacitors to connect the input terminals of the DC machine if it is needed. These capacitors are suitable for high voltage applications. Their voltage ratings are 400V.

## Fuse

30A 6x30mm Ceramic Fuses

According to our calculations and circuit element current rates, current value should not exceed some limits. In order to prevent damage in the circuit, we bought ceramic fuses.

## Gate Driver

HCPL-3120 2.5 Amp Output Current IGBT Gate Drive Optocoupler

In order to prevent high voltage drop on gate-emitter voltage of IGBT, we have added a gate driver to our design. The HCPL3120 has an insulation voltage of VIORM=630 Vpeak and it provides 2.5A to the gate of IGBT. These values are very high among other gate drivers and suitable for our design.

MINIMUM PEAK OUTPUT CURRENT | 2A
INSULATION VOLTAGE | 630V
TEMPERATURE RANGE | 40-100°C
MAXIMUM SWITCHING SPEED | 500ns

## Heat Sink

# Thermal Calculations

In analysis part, there are 5 components that should be considered in thermal view. These are three-phase rectifier unit, the timer unit, gate driver unit, IGBT which is aimed to be used as the switch, and buck converter diode. At our on-going stage for the project, the losses for timer and gate driver unit were hold since the prototype and more experimental measurements are presumably needed.

## IGBT

Over IGBT, there are 2 types of losses: switching losses and conduction losses. Switching losses are calculated by given section of the datasheet while taking into maximum frequency account:

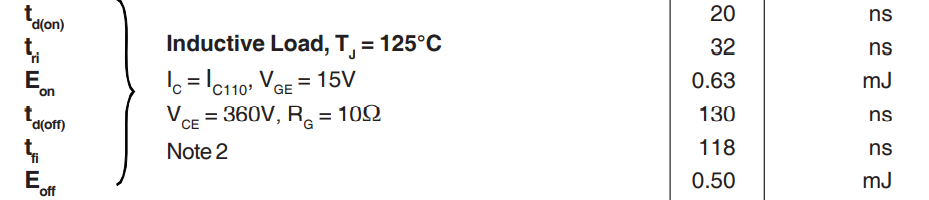
[picture p35: figure]

For ON mode with V_(GE) =15V, V_(CE) =360 V,R_G =10Ω :

E_(on) =0.40 mJ @25°C, and E_(on) =0.63 mJ @125°C,

For OFF mode with V_(GE) =15V, V_(CE) =360 V,R_G =10Ω :

E_(off) =0.30 mJ @25°C,and E_(off) =0.50 mJ

As maximum frequency was limited at 5 kHz,

P_(switching) =f*(E_(on) +E_(off) )=3.5 W @25°C

P_(switching) =f*(E_(on) +E_(off) )=4 W @125°C

Conduction losses can be calculated for IGBT by given section of the datasheet:

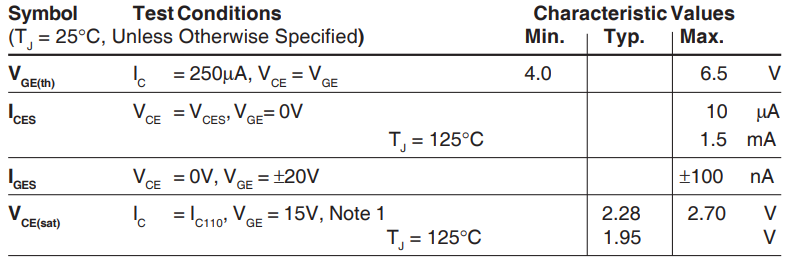
[picture p36: figure]

as V_(GE) =15V, V_(CE) _(sat) =1.95 V with 125°C and V_(CE) _(sat) =2.7 V with 25°C

I_(CES) =1.5 mA with 125°C and I_(CES) =10 µA with 25°C

P_(conduction) (125°C)=V_(CE_(sat)) *I_(CES) =2.925 mW

P_(conduction) (25°C)=V_(CE_(sat)) *I_(CES) =27 µW= 0.027 mW

Overall, for our IGBT

P_(loss) =P_(switching) + P_(conduction) ≅3.527 W at 25°C

P_(loss) =P_(switching) + P_(conduction) ≅6.925 W at 125°C

### Thermal circuit for IGBT

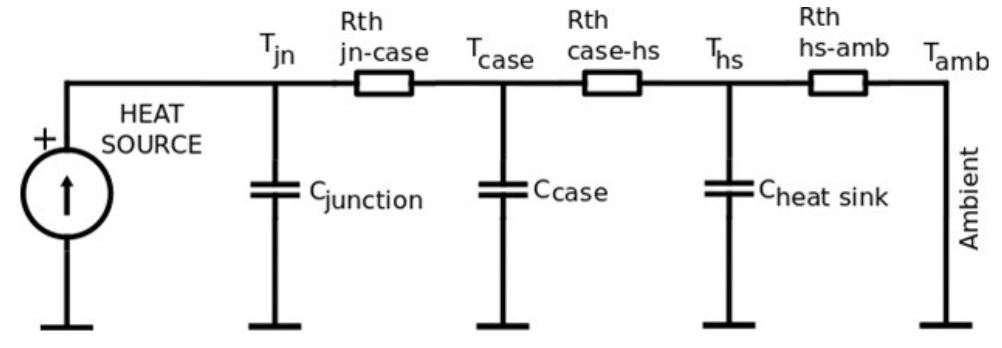
[picture p37: figure]

Typical thermal model in power electronics

Ignoring the capacitances for steady state,

P_(dissipated) =P_(loss) ≅3.527 W was found at 25 °C.

R_(θjunction-case) =0.65 °C /W and R_(θcase-sink) =0.21 °C /W

And

R_(θheatsink-ambience) =70 °C/W for TO220 [1]

Overall,

R_(θjunction-ambience) =70.86 °C/W

Considering the changes in the parameters after 125 °C ,

(125 °C-25°C)/(R_(θjunction-ambience))≈1.411 W dissipated loss until temp reaches to 125 °C

T_(junction) =T_(ambient) +R_(θjunction-ambience) *(P_(loss) )

T_(junction) =125+70.86 °C/W*(3.527 W-1.411 W )≈236 Celsius

## Diodes

### Rectifier Three-Phase Diode Losses

Conduction losses,

P_(loss) =V_F *I_F *D

@25°C

P_(loss) =6*1.2*15*0.8=86.4W

Due to lack of data on datasheet, we could not calculate switching losses. (trr is not given). Also, we could not calculate temperature increase of diode since there is only R_(JA) value on datasheet.

### Buck Converter Diode Losses

Conduction losses,

P_(loss) =V_F *I_F *D

@25°C

P_(loss) =1.6*15*0.8=19.2W

Switching loss,

P_(sw_(loss)) =V_R *f_(sw) *t_(rr) *I_R

@25°C

P_(sw_(loss)) =180V*50Hz*50ns*50µA=22.5nW

@125°C

P_(sw_(loss)) =180V*50Hz*50ns*7mA=3.15µW

For temperature increase of diode,

T_(junction) =T_J +R_(JA) *(P_(loss) )

T_(junction) =298K+35W/K*51.8

T_(junction) =970K

T_(junction) =697°C

# Implementation

# Conclusion
