kkaya674/EE463-TermProject/Reports/Current Values for IdealScheme.pdf

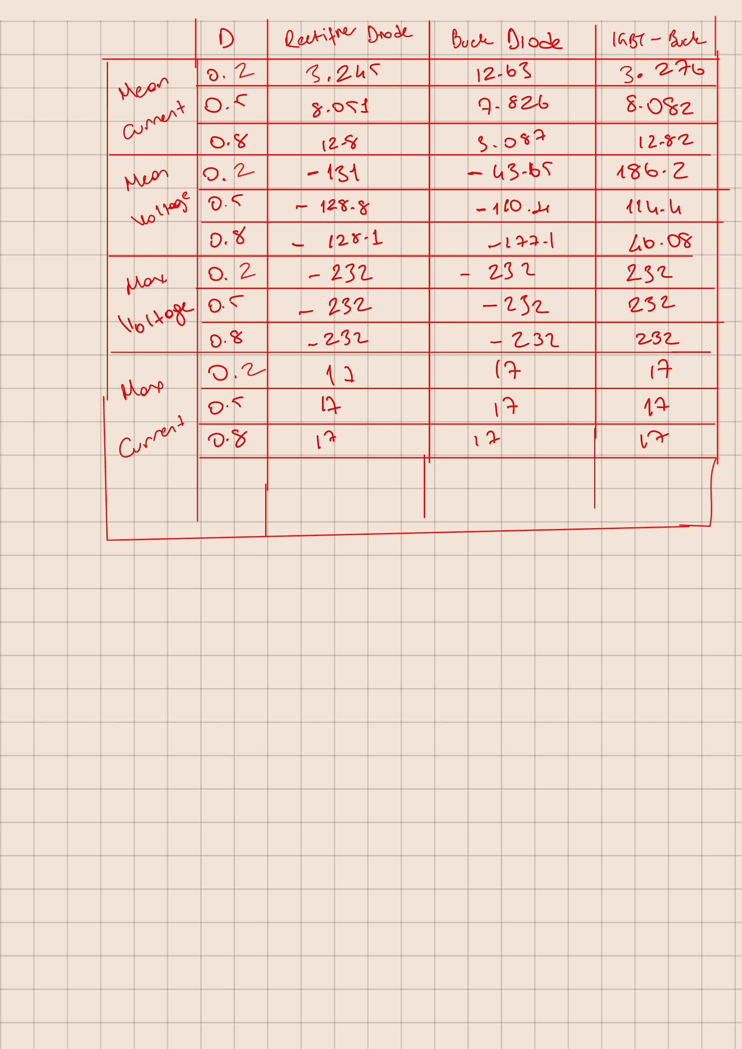
[picture p79: page 1]
