kkaya674/EE463-TermProject/Datasheets/GateDriver/Gate-driver-circuit-for-MOSFET-IGBT-Fig10-shows-the-MATLAB-simulation-of-whole-system.ppm.png

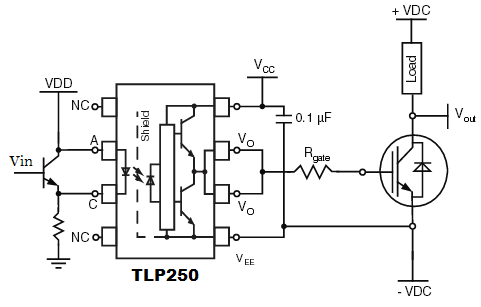
Datasheets/GateDriver/Gate-driver-circuit-for-MOSFET-IGBT-Fig10-shows-the-MATLAB-simulation-of-whole-system.ppm.png
