kkaya674/EE463-TermProject/Demo/20220121_111647.jpg

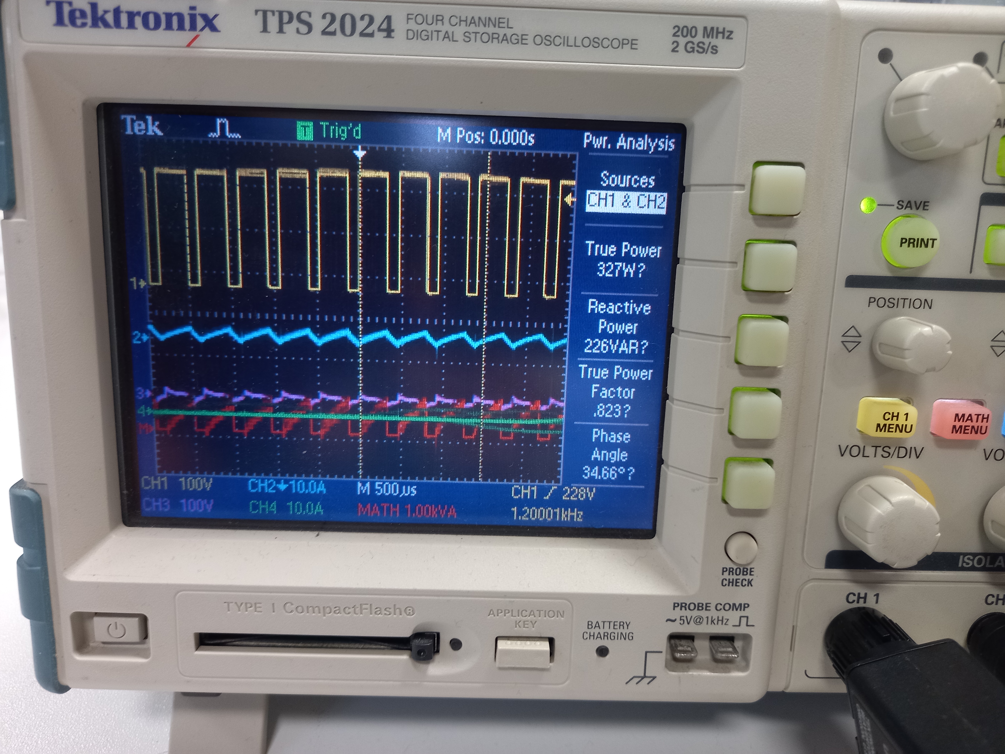
Demo/20220121_111647.jpg
