kkaya674/EE463-TermProject/Demo/20220121_112749.jpg

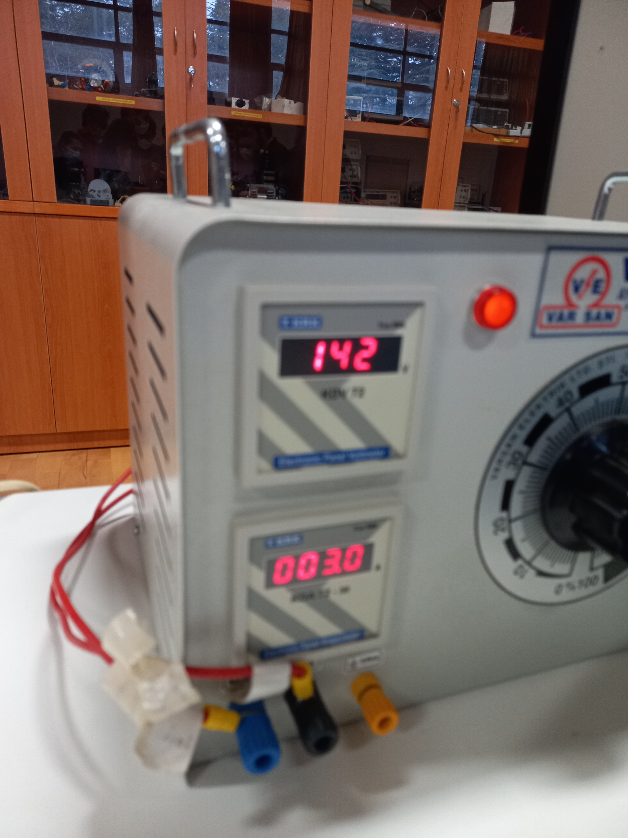
Demo/20220121_112749.jpg
