kkaya674/EE463-TermProject/Demo/20220121_112941.jpg

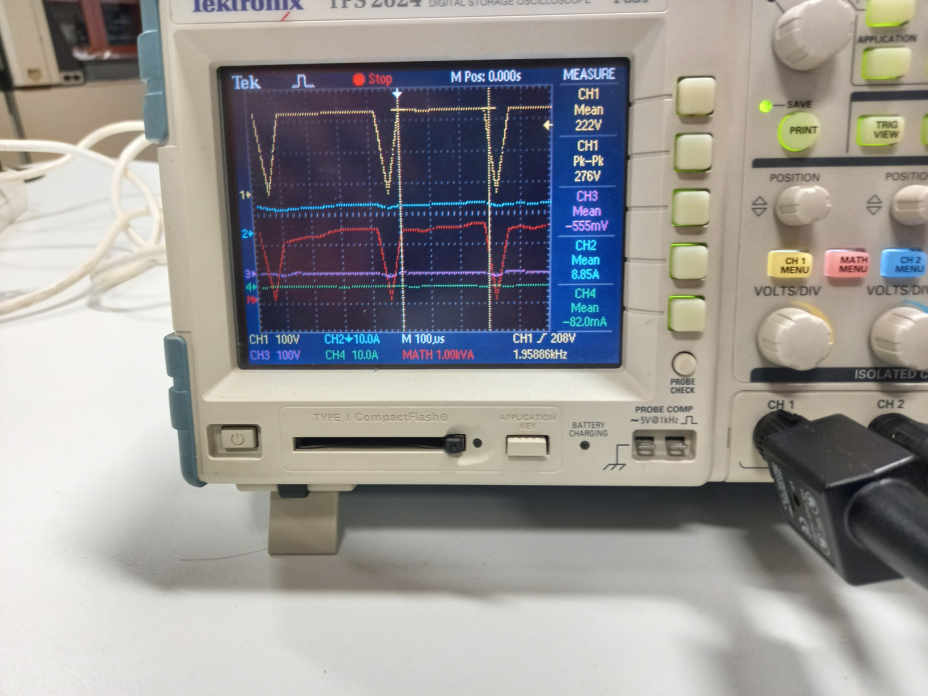
Demo/20220121_112941.jpg
