kkaya674/EE463-TermProject/Demo/IMG-20220121-WA0007.jpg

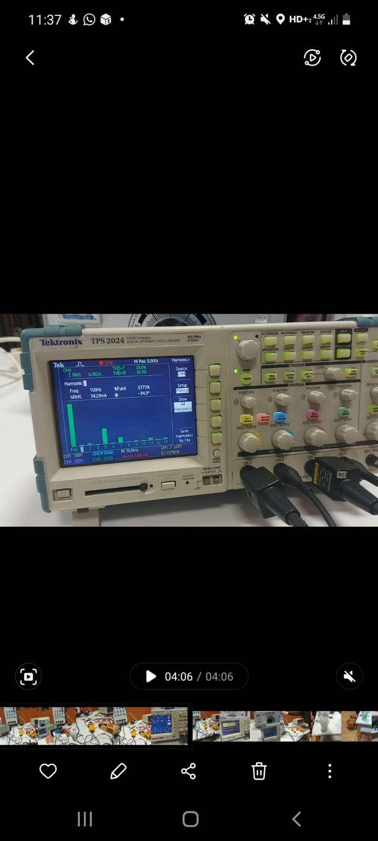
Demo/IMG-20220121-WA0007.jpg
