kkaya674/EE463-TermProject/Formulations/ASTABLE NE555 Controller Formulations/Ekran Resmi 2021-12-25 16.34.23.png

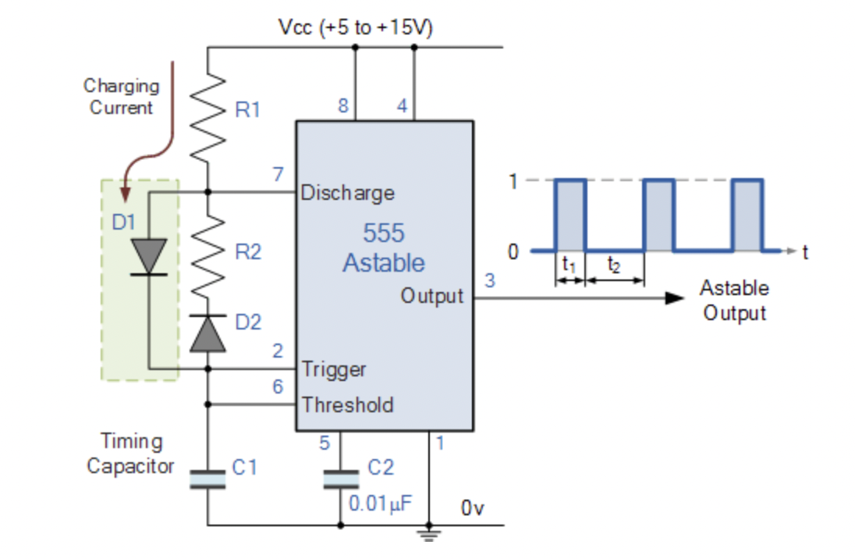
Formulations/ASTABLE NE555 Controller Formulations/Ekran Resmi 2021-12-25 16.34.23.png
