kkaya674/EE463-TermProject/Formulations/ASTABLE NE555 Controller Formulations/ImprovedController.png

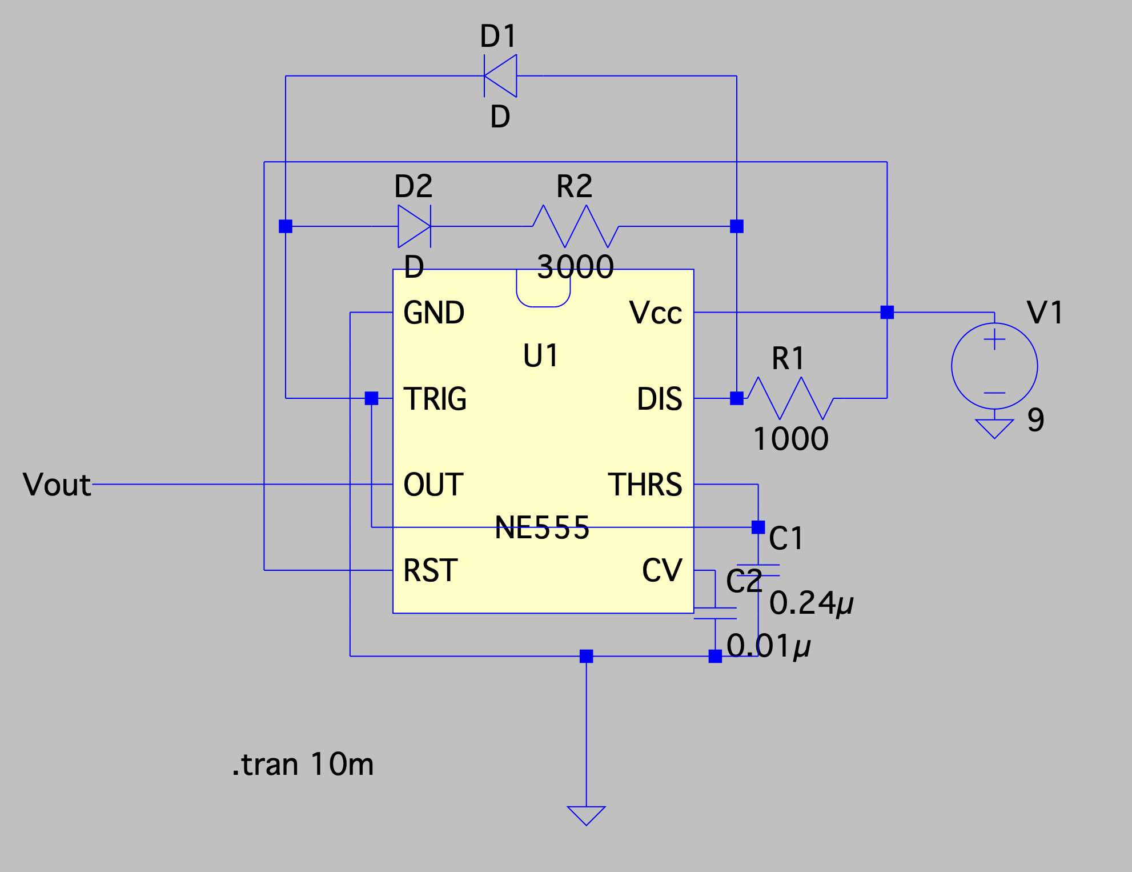
Formulations/ASTABLE NE555 Controller Formulations/ImprovedController.png
