kkaya674/EE463-TermProject/Formulations/ASTABLE NE555 Controller Formulations/nonImproved/50%DutyCycleFormulation.png

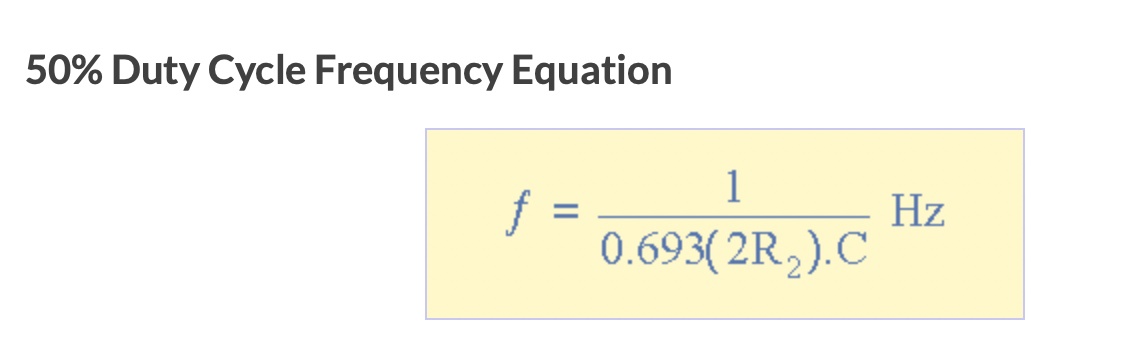
Formulations/ASTABLE NE555 Controller Formulations/nonImproved/50%DutyCycleFormulation.png
