kkaya674/EE463-TermProject/Formulations/ASTABLE NE555 Controller Formulations/nonImproved/Capacitor & OutputVoltage.png

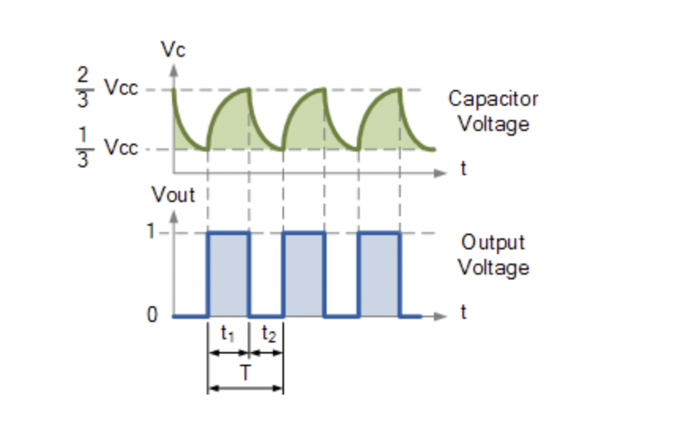
Formulations/ASTABLE NE555 Controller Formulations/nonImproved/Capacitor & OutputVoltage.png
