kkaya674/EE463-TermProject/Formulations/ASTABLE NE555 Controller Formulations/nonImproved/Circuit Scheme .png

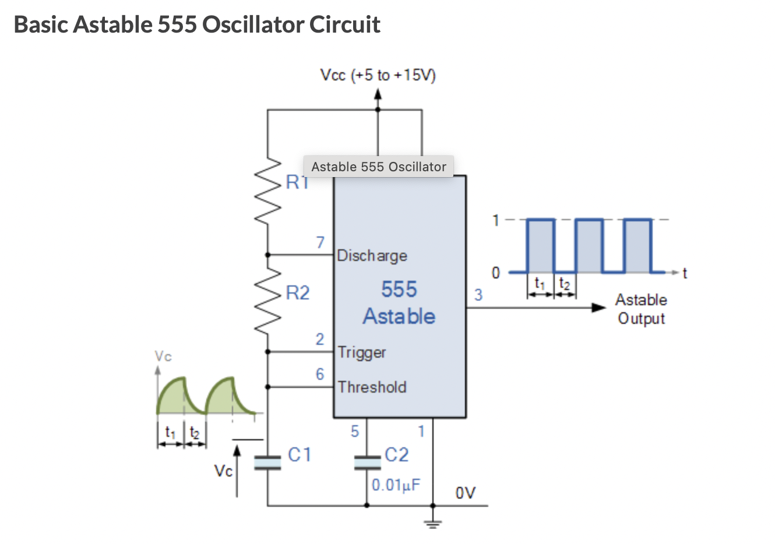
Formulations/ASTABLE NE555 Controller Formulations/nonImproved/Circuit Scheme .png
