kkaya674/EE463-TermProject/Formulations/ASTABLE NE555 Controller Formulations/nonImproved/Duty Cycle Formulation.png

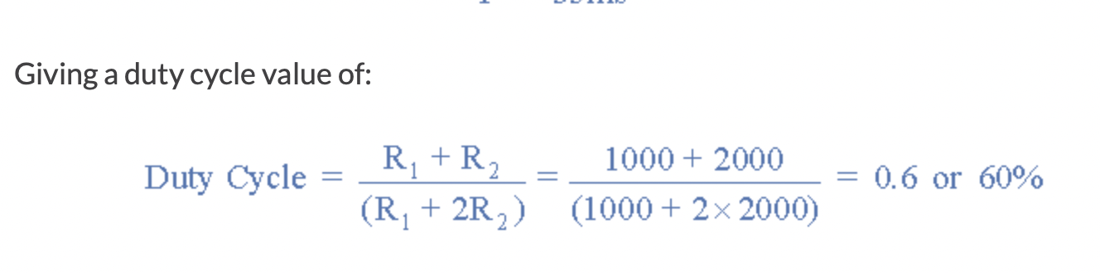
Formulations/ASTABLE NE555 Controller Formulations/nonImproved/Duty Cycle Formulation.png
