kkaya674/EE463-TermProject/Formulations/ASTABLE NE555 Controller Formulations/nonImproved/Formulations1.png

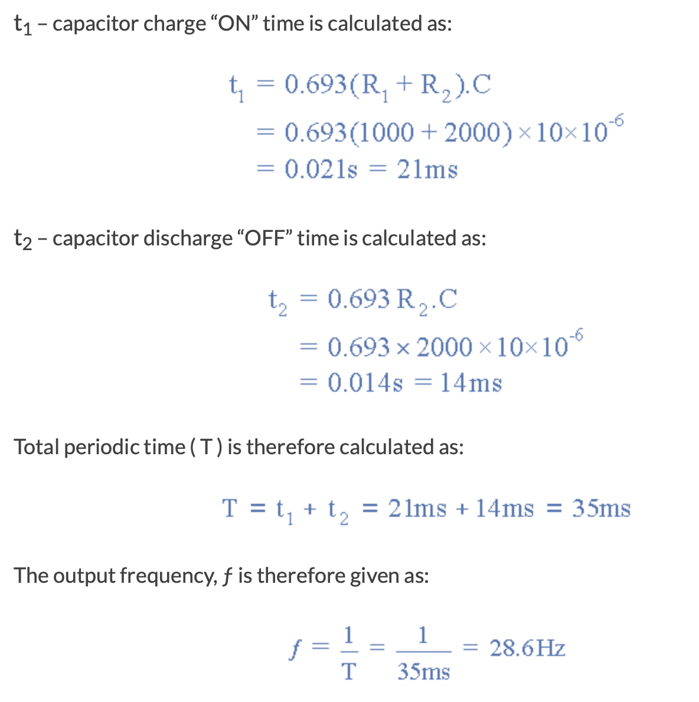
Formulations/ASTABLE NE555 Controller Formulations/nonImproved/Formulations1.png
