kkaya674/EE463-TermProject/Formulations/ASTABLE NE555 Controller Formulations/nonImproved/Oscillator Frequency Equation.png

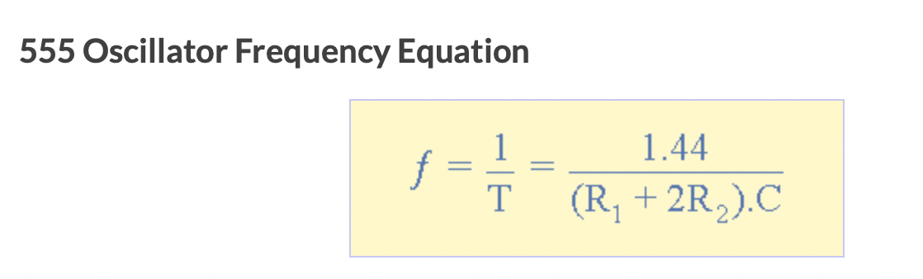
Formulations/ASTABLE NE555 Controller Formulations/nonImproved/Oscillator Frequency Equation.png
