kkaya674/EE463-TermProject/Graphs /0.2DutyCycle/0.2 Duty cycle output for different capacitors/1x270uF_all_trueESR.PNG

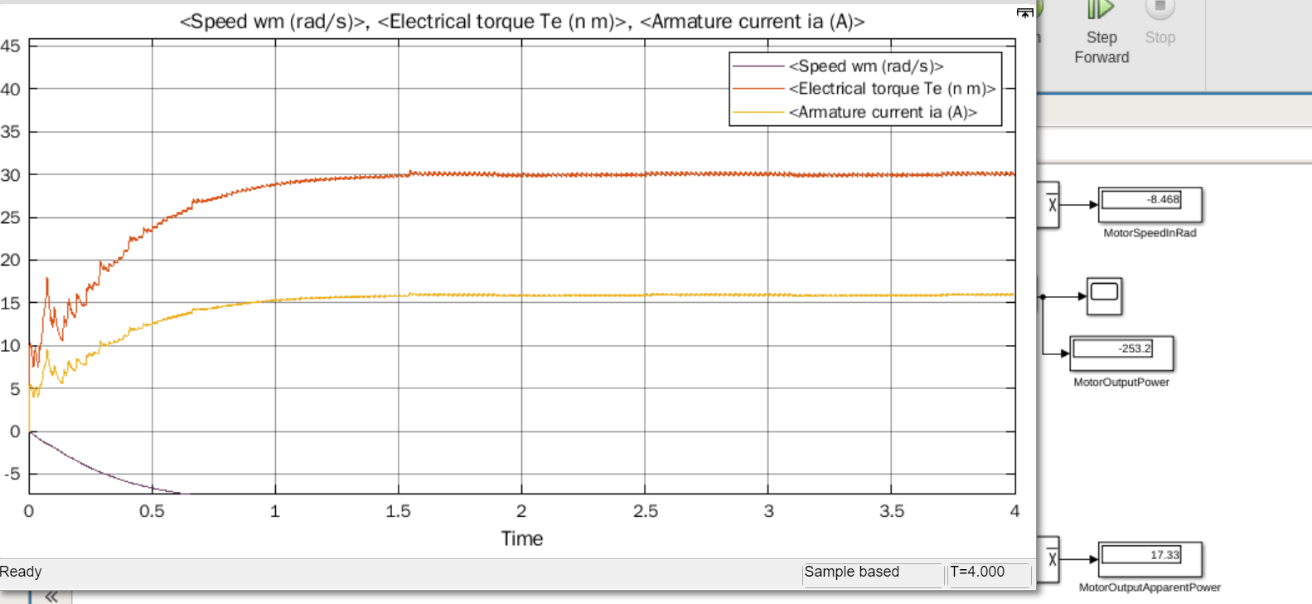
Graphs /0.2DutyCycle/0.2 Duty cycle output for different capacitors/1x270uF_all_trueESR.PNG
