kkaya674/EE463-TermProject/Graphs /0.2DutyCycle/0.2 Duty cycle output for different capacitors/2x2.2uFall.PNG

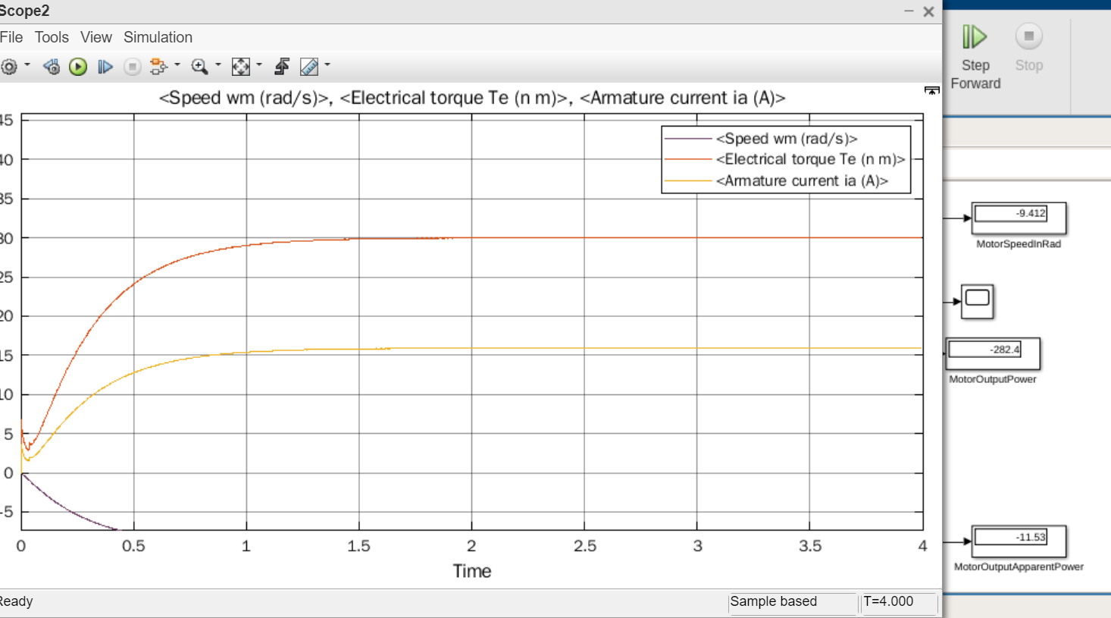
Graphs /0.2DutyCycle/0.2 Duty cycle output for different capacitors/2x2.2uFall.PNG
