kkaya674/EE463-TermProject/Graphs /0.2DutyCycle/0.2 Duty cycle output for different capacitors/2x68uF_all_moreESR.PNG

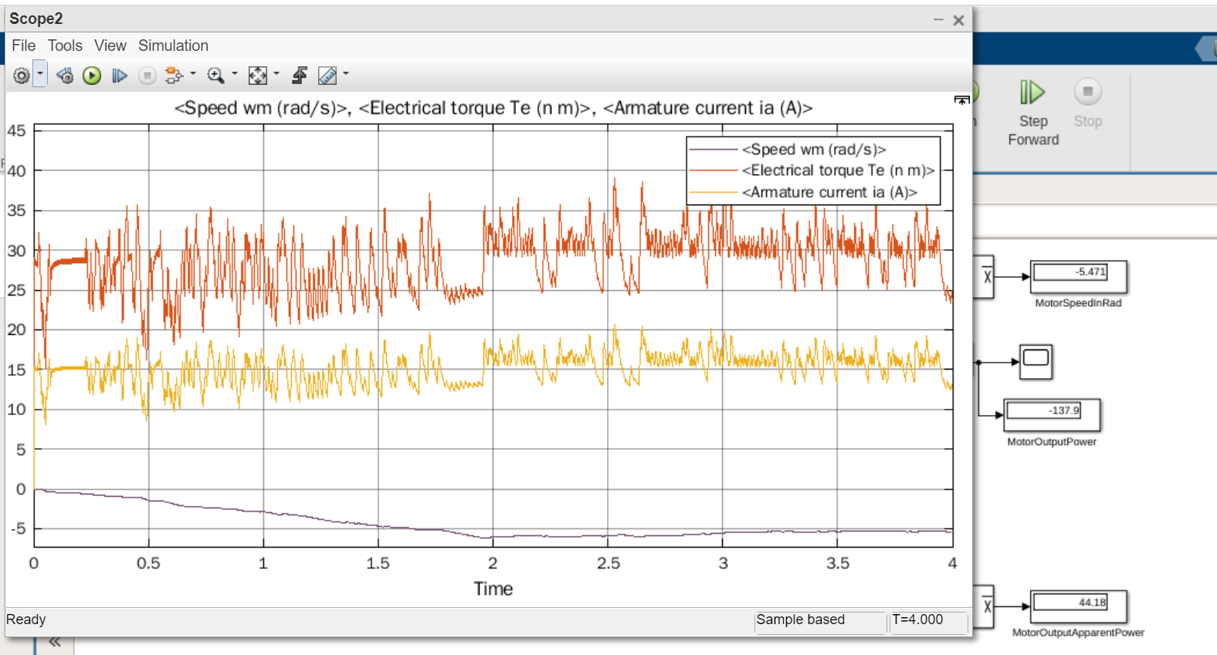
Graphs /0.2DutyCycle/0.2 Duty cycle output for different capacitors/2x68uF_all_moreESR.PNG
