kkaya674/EE463-TermProject/Graphs /0.2DutyCycle/BuckConverterDiodeCurrent.jpeg

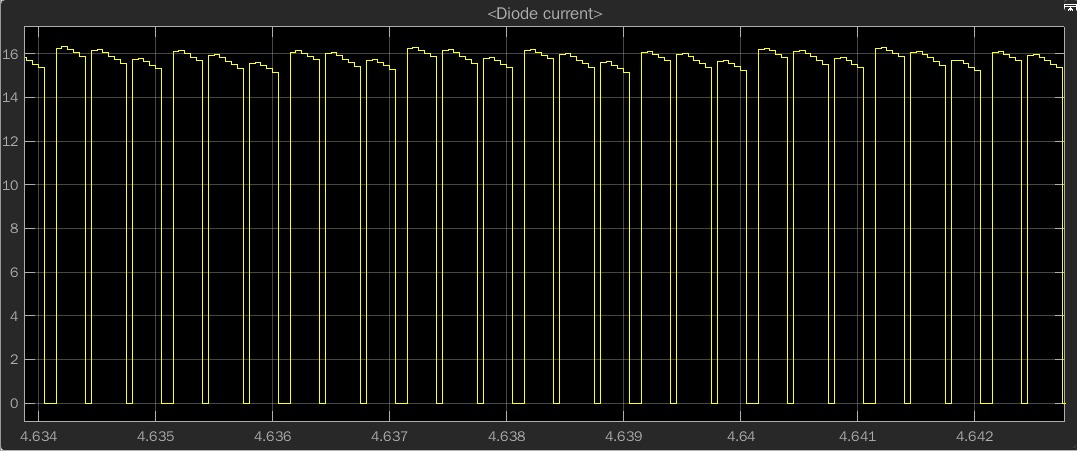
Graphs /0.2DutyCycle/BuckConverterDiodeCurrent.jpeg
