kkaya674/EE463-TermProject/Graphs /0.2DutyCycle/BuckConverterDiodeVoltage.jpeg

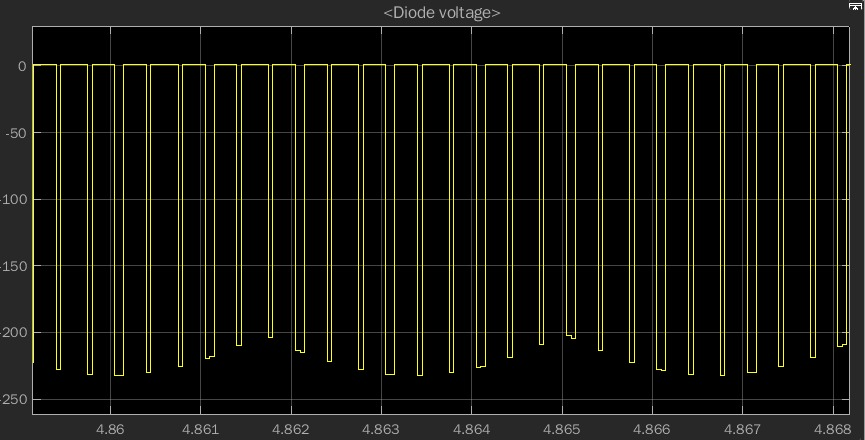
Graphs /0.2DutyCycle/BuckConverterDiodeVoltage.jpeg
