kkaya674/EE463-TermProject/Graphs /0.2DutyCycle/buckConverterOutputVoltage.png

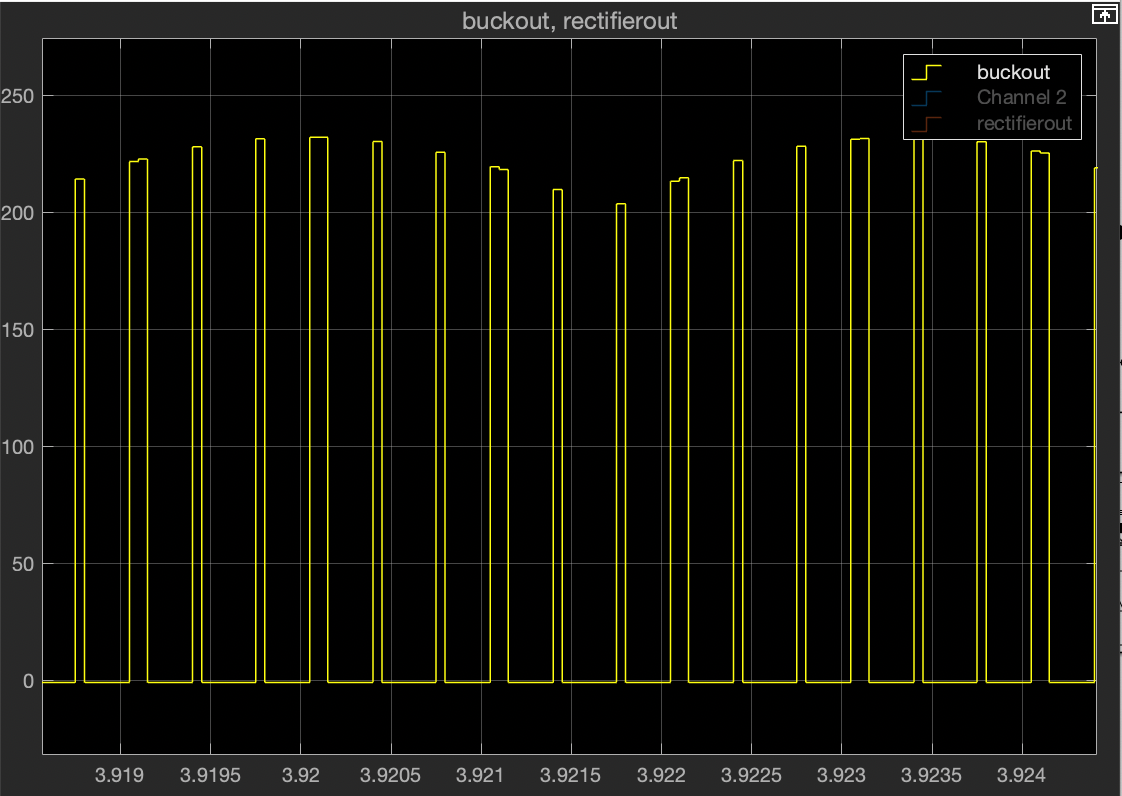
Graphs /0.2DutyCycle/buckConverterOutputVoltage.png
