kkaya674/EE463-TermProject/Graphs /0.2DutyCycle/IGBTCurrent.png

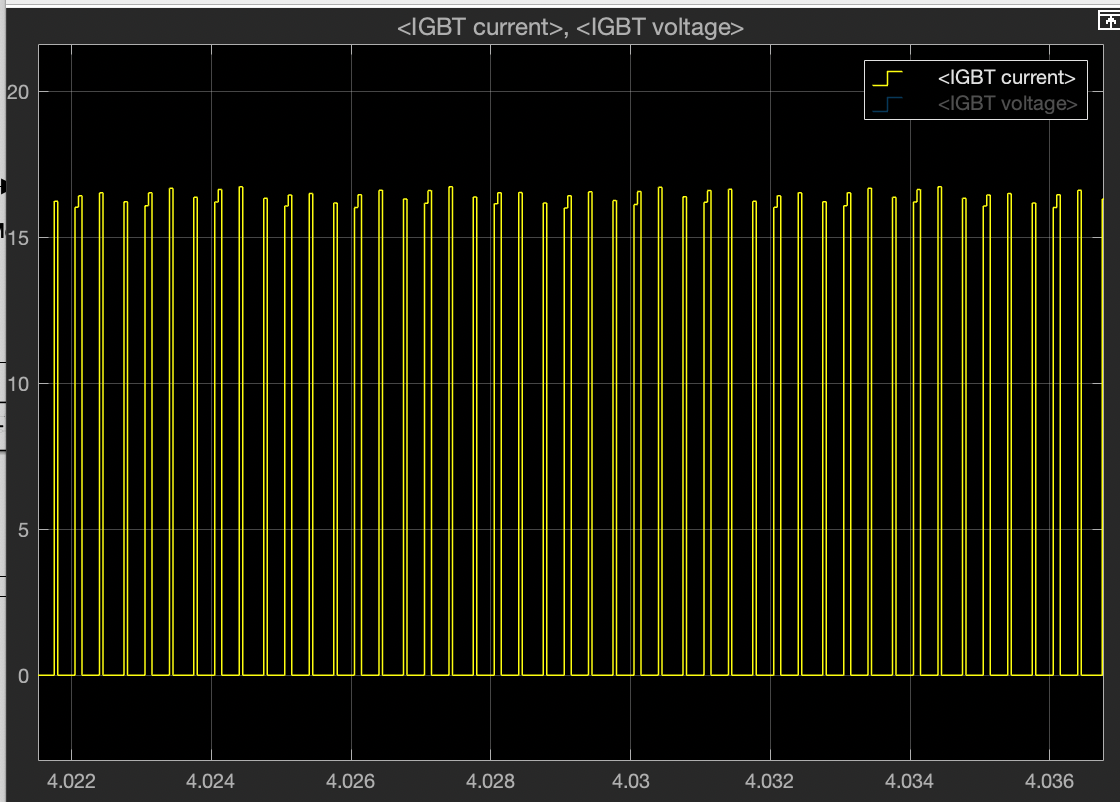
Graphs /0.2DutyCycle/IGBTCurrent.png
