kkaya674/EE463-TermProject/Graphs /0.2DutyCycle/MeanIGBT.jpeg

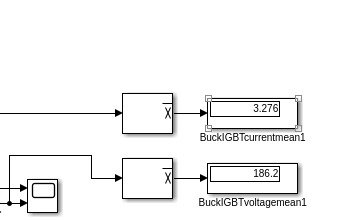
Graphs /0.2DutyCycle/MeanIGBT.jpeg
