kkaya674/EE463-TermProject/Graphs /0.2DutyCycle/MeanRectifierDiodecurrent.png

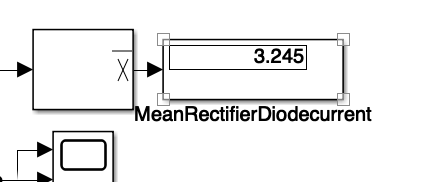
Graphs /0.2DutyCycle/MeanRectifierDiodecurrent.png
