kkaya674/EE463-TermProject/Graphs /0.2DutyCycle/MeanRectifierDiodeVoltage.jpeg

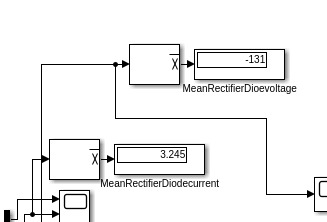
Graphs /0.2DutyCycle/MeanRectifierDiodeVoltage.jpeg
