kkaya674/EE463-TermProject/Graphs /0.2DutyCycle/MotorInputVoltage.png

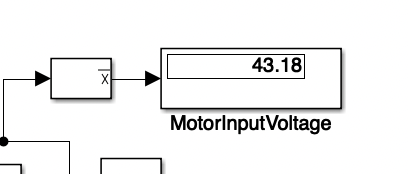
Graphs /0.2DutyCycle/MotorInputVoltage.png
