kkaya674/EE463-TermProject/Graphs /0.2DutyCycle/MotorOutputApparentPower.png

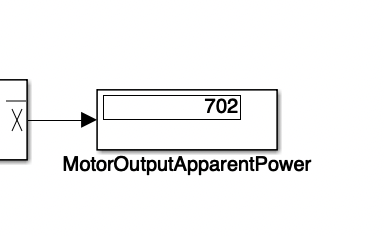
Graphs /0.2DutyCycle/MotorOutputApparentPower.png
