kkaya674/EE463-TermProject/Graphs /0.2DutyCycle/MotorOutputPower.png

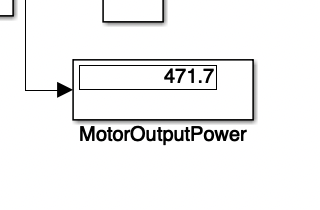
Graphs /0.2DutyCycle/MotorOutputPower.png
