kkaya674/EE463-TermProject/Graphs /0.2DutyCycle/MotorSpeedInRad.png

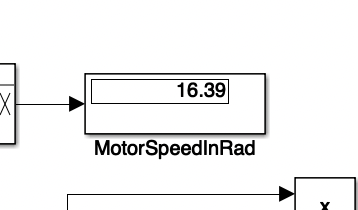
Graphs /0.2DutyCycle/MotorSpeedInRad.png
