kkaya674/EE463-TermProject/Graphs /0.2DutyCycle/Motowaveforms_Soft_starting_D=0.2.png

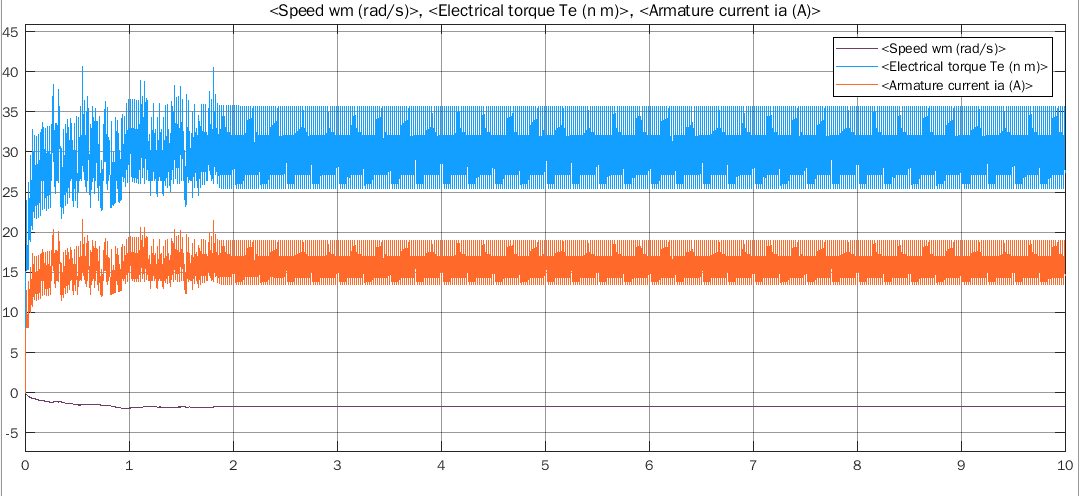
Graphs /0.2DutyCycle/Motowaveforms_Soft_starting_D=0.2.png
