kkaya674/EE463-TermProject/Graphs /0.2DutyCycle/RectifierDiodeCurrent.png

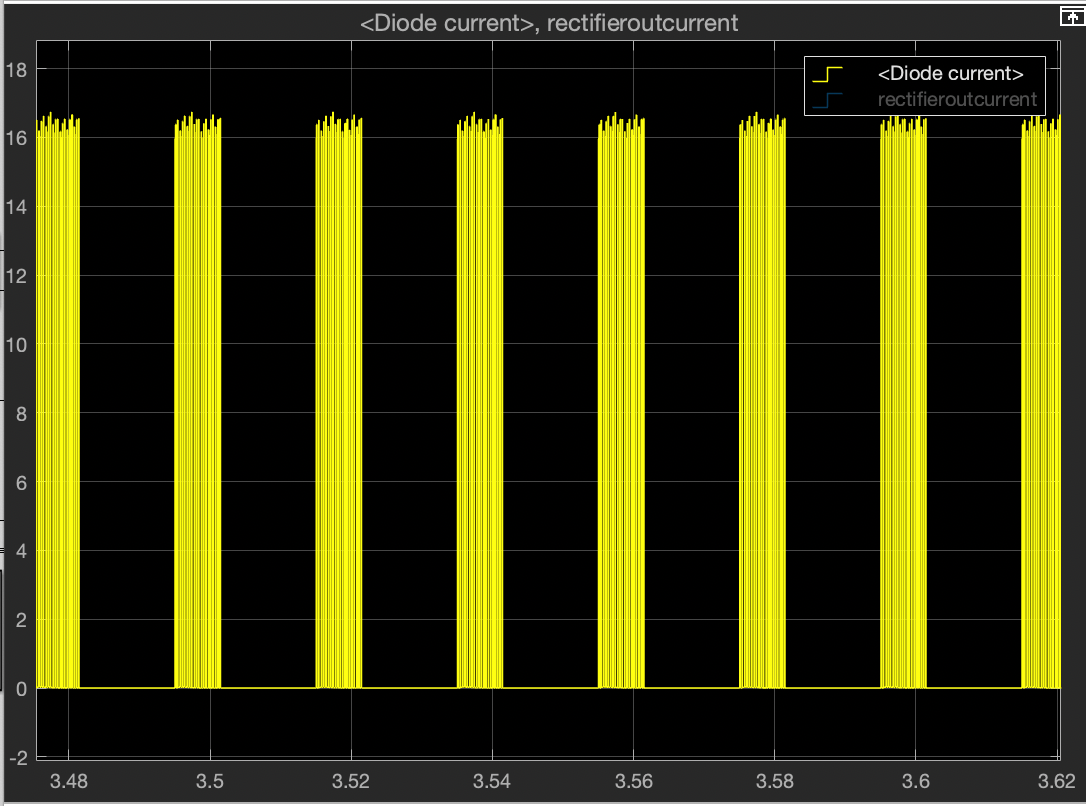
Graphs /0.2DutyCycle/RectifierDiodeCurrent.png
