kkaya674/EE463-TermProject/Graphs /0.2DutyCycle/RectifierDiodeVoltage.jpeg

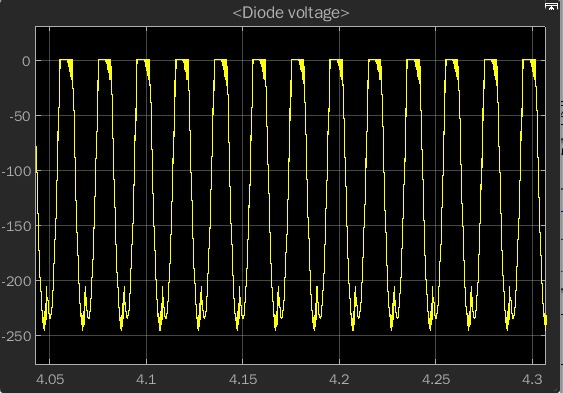
Graphs /0.2DutyCycle/RectifierDiodeVoltage.jpeg
