kkaya674/EE463-TermProject/Graphs /0.2DutyCycle/RectifierOutputcurrent.png

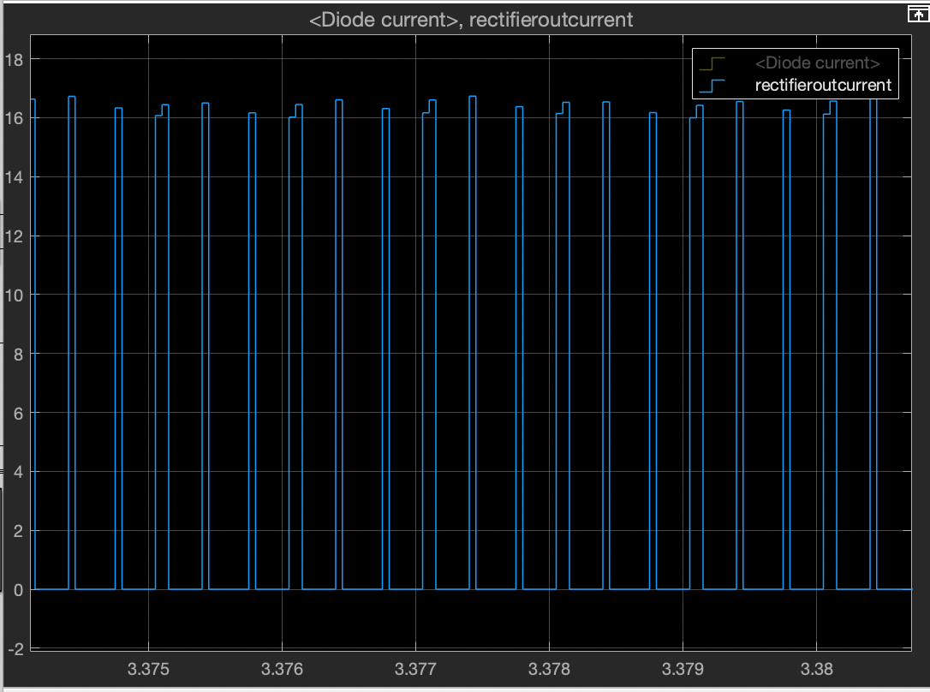
Graphs /0.2DutyCycle/RectifierOutputcurrent.png
