kkaya674/EE463-TermProject/Graphs /0.2DutyCycle/RectifierOutputPower.png

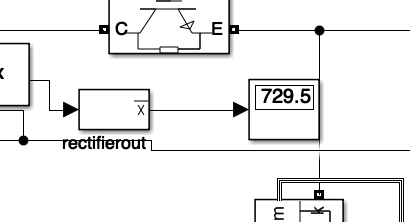
Graphs /0.2DutyCycle/RectifierOutputPower.png
