kkaya674/EE463-TermProject/Graphs /0.2DutyCycle/rectifieroutputvoltage.png

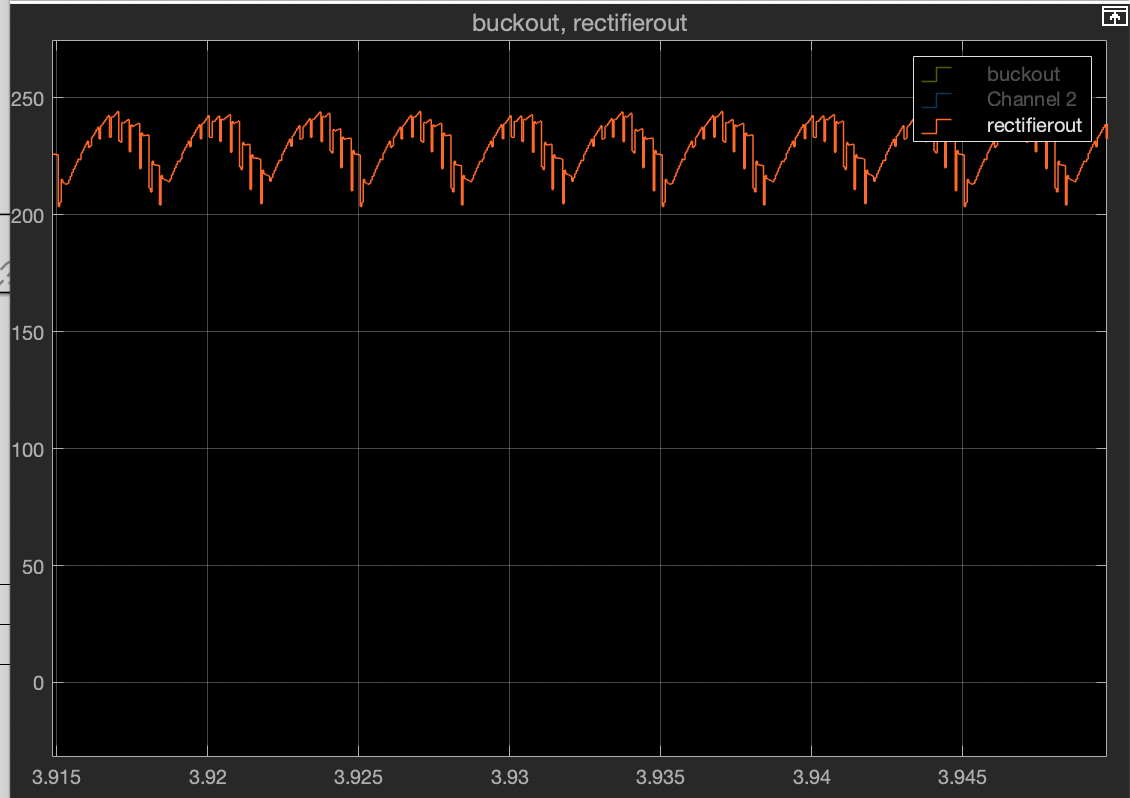
Graphs /0.2DutyCycle/rectifieroutputvoltage.png
