kkaya674/EE463-TermProject/Graphs /0.5DutyCycle/BuckConverterDiodeCurrent.png

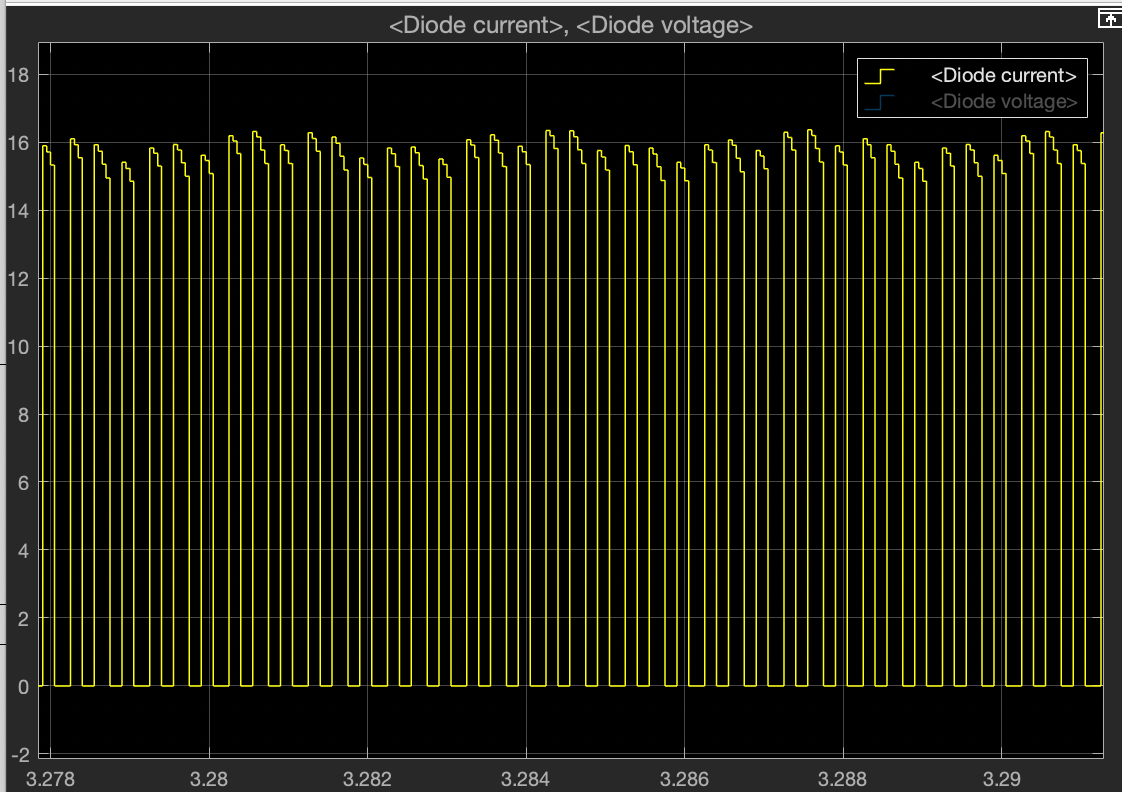
Graphs /0.5DutyCycle/BuckConverterDiodeCurrent.png
