kkaya674/EE463-TermProject/Graphs /0.5DutyCycle/IBGTCurrent.png

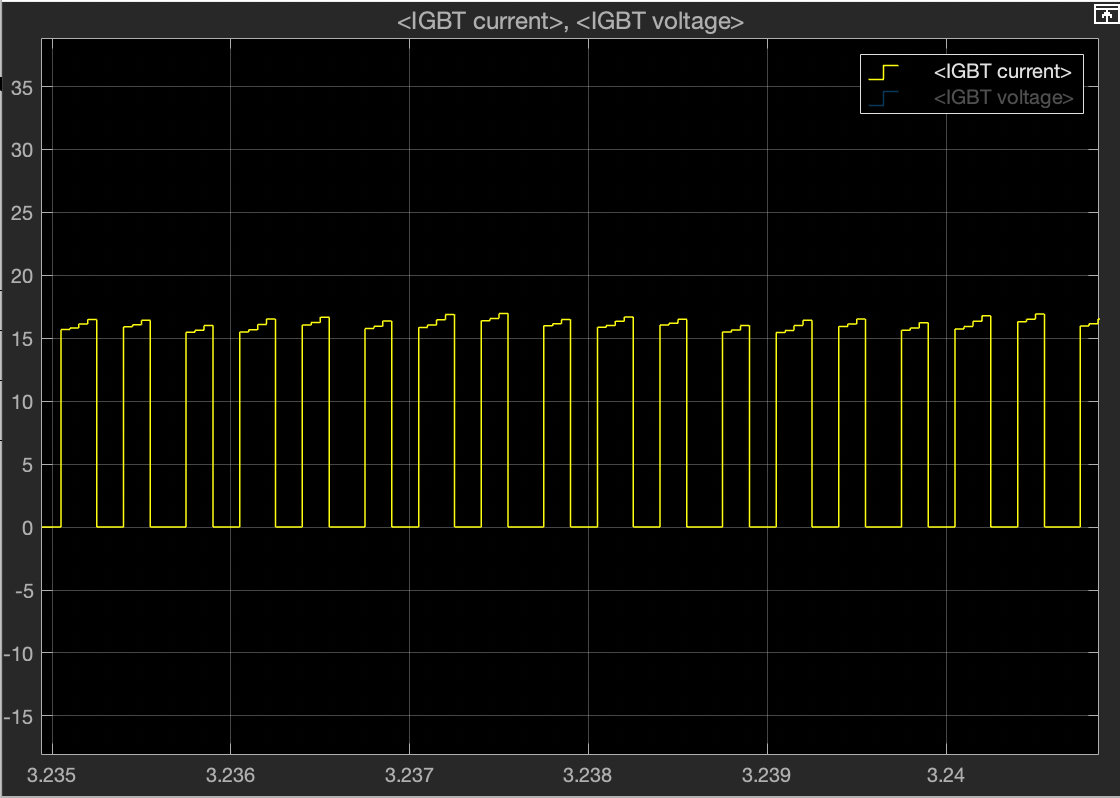
Graphs /0.5DutyCycle/IBGTCurrent.png
