kkaya674/EE463-TermProject/Graphs /0.5DutyCycle/IGBTVoltage.png

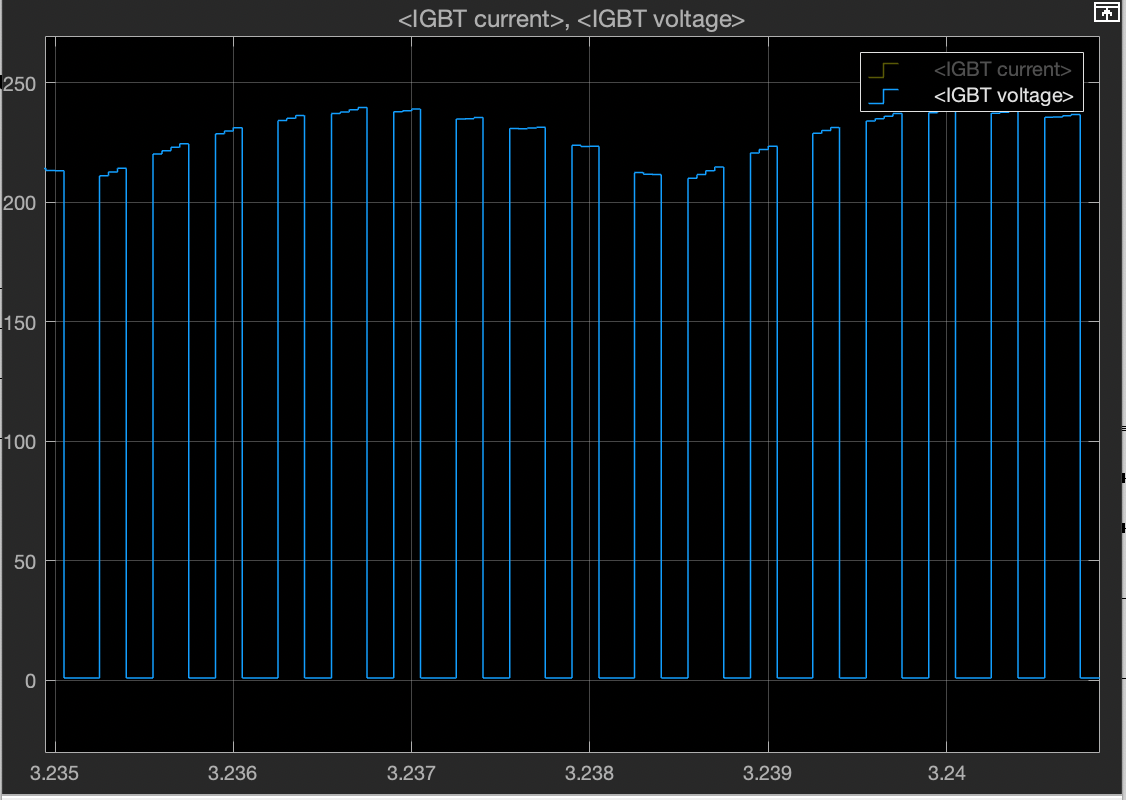
Graphs /0.5DutyCycle/IGBTVoltage.png
