kkaya674/EE463-TermProject/Graphs /0.5DutyCycle/IGBTvoltage_0.5.jpeg

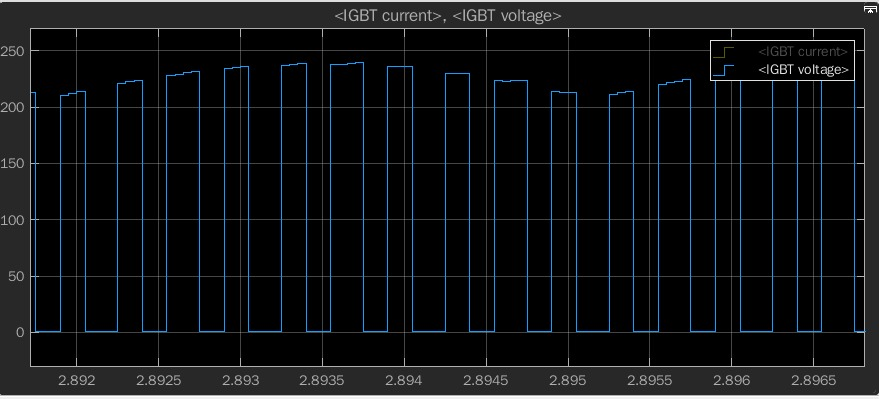
Graphs /0.5DutyCycle/IGBTvoltage_0.5.jpeg
