kkaya674/EE463-TermProject/Graphs /0.5DutyCycle/MeanRectifierDiodeCurrent.png

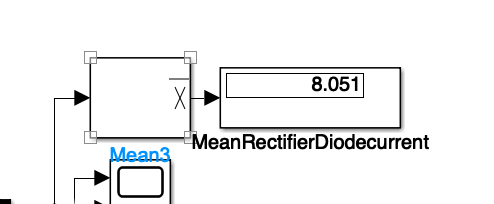
Graphs /0.5DutyCycle/MeanRectifierDiodeCurrent.png
