kkaya674/EE463-TermProject/Graphs /0.5DutyCycle/MotorInputVoltage.png

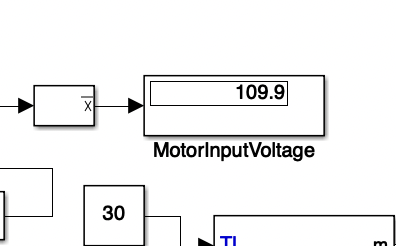
Graphs /0.5DutyCycle/MotorInputVoltage.png
