kkaya674/EE463-TermProject/Graphs /0.5DutyCycle/MotorOutputApparentPower.png

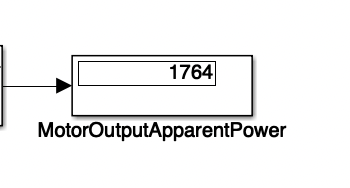
Graphs /0.5DutyCycle/MotorOutputApparentPower.png
