kkaya674/EE463-TermProject/Graphs /0.5DutyCycle/MotorOutputPower.png

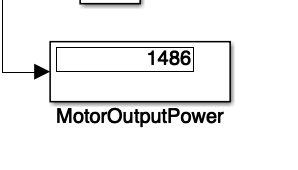
Graphs /0.5DutyCycle/MotorOutputPower.png
