kkaya674/EE463-TermProject/Graphs /0.5DutyCycle/RectfierOutputApparentPower.png

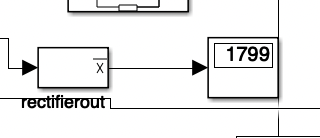
Graphs /0.5DutyCycle/RectfierOutputApparentPower.png
