kkaya674/EE463-TermProject/Graphs /0.5DutyCycle/RectifierDiodeCurrent.png

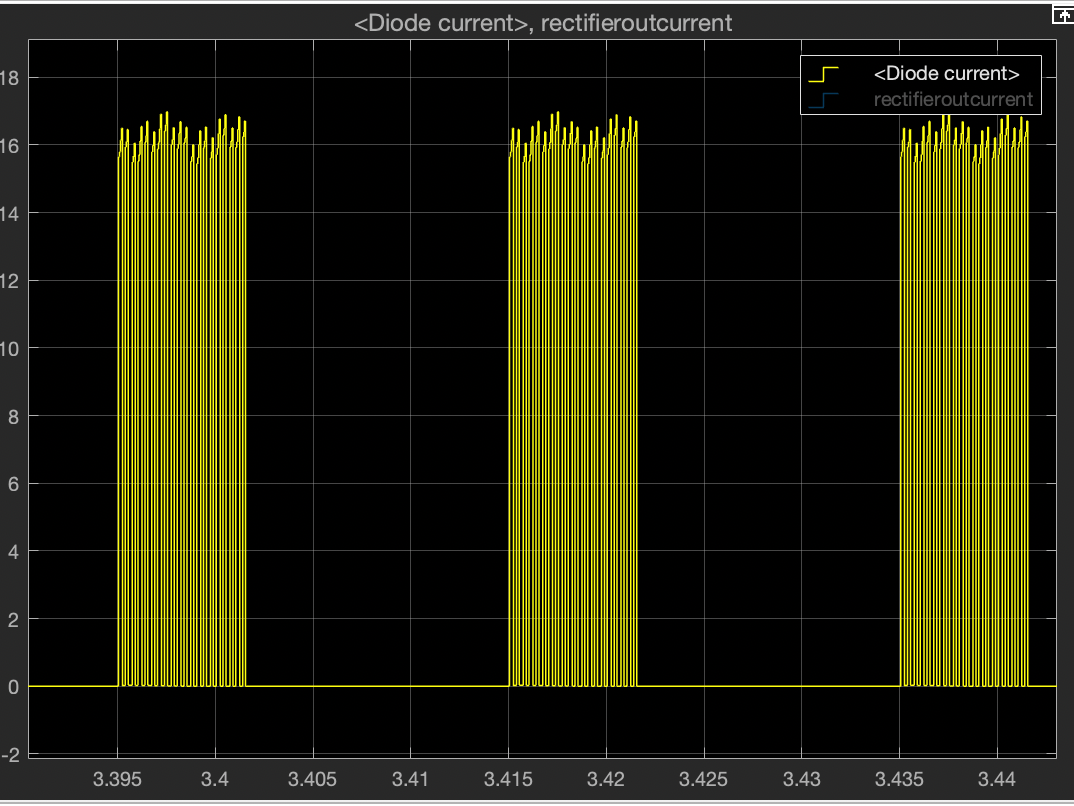
Graphs /0.5DutyCycle/RectifierDiodeCurrent.png
