kkaya674/EE463-TermProject/Graphs /0.5DutyCycle/RectifierDiodeCurrentInDetail.png

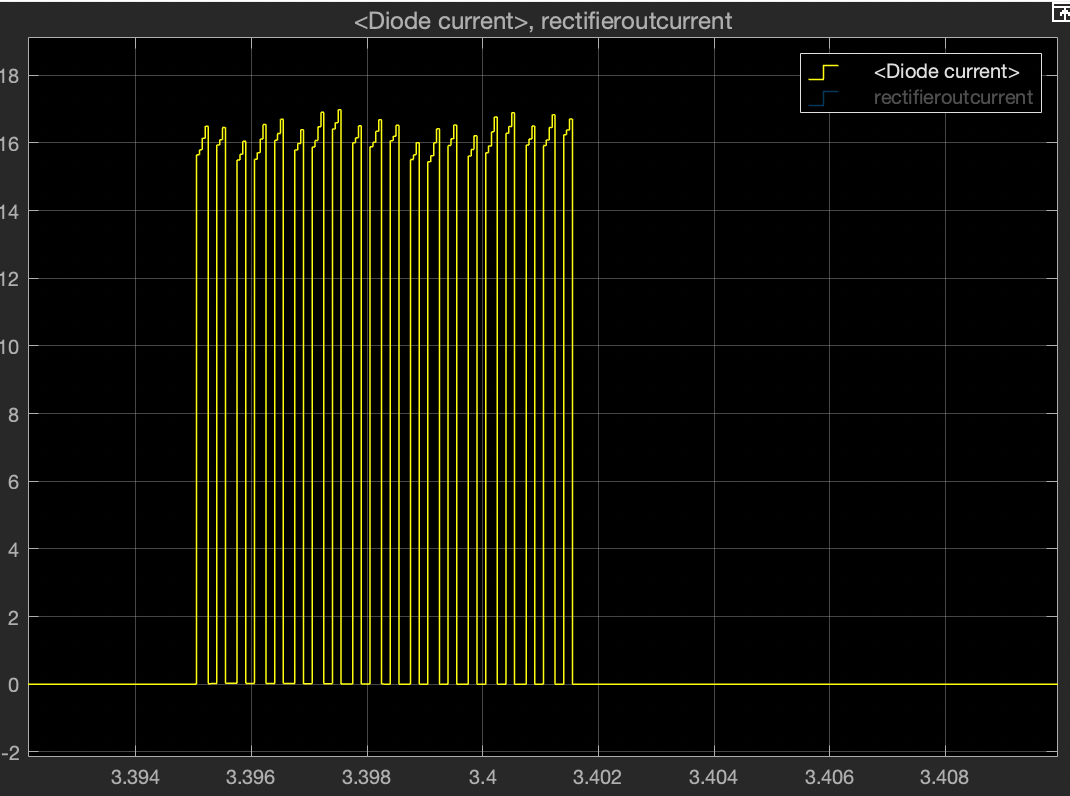
Graphs /0.5DutyCycle/RectifierDiodeCurrentInDetail.png
