kkaya674/EE463-TermProject/Graphs /0.5DutyCycle/RectifierOutCurrent.png

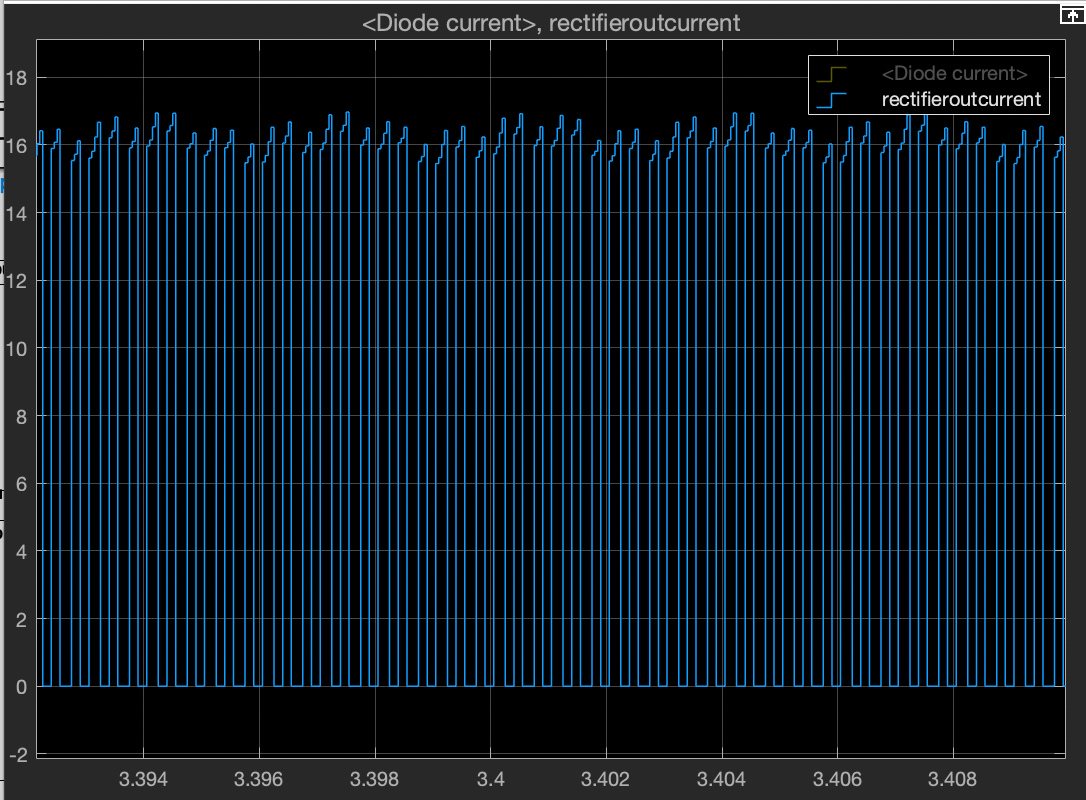
Graphs /0.5DutyCycle/RectifierOutCurrent.png
