kkaya674/EE463-TermProject/Graphs /0.5DutyCycle/RectifierOutputCurrent.png

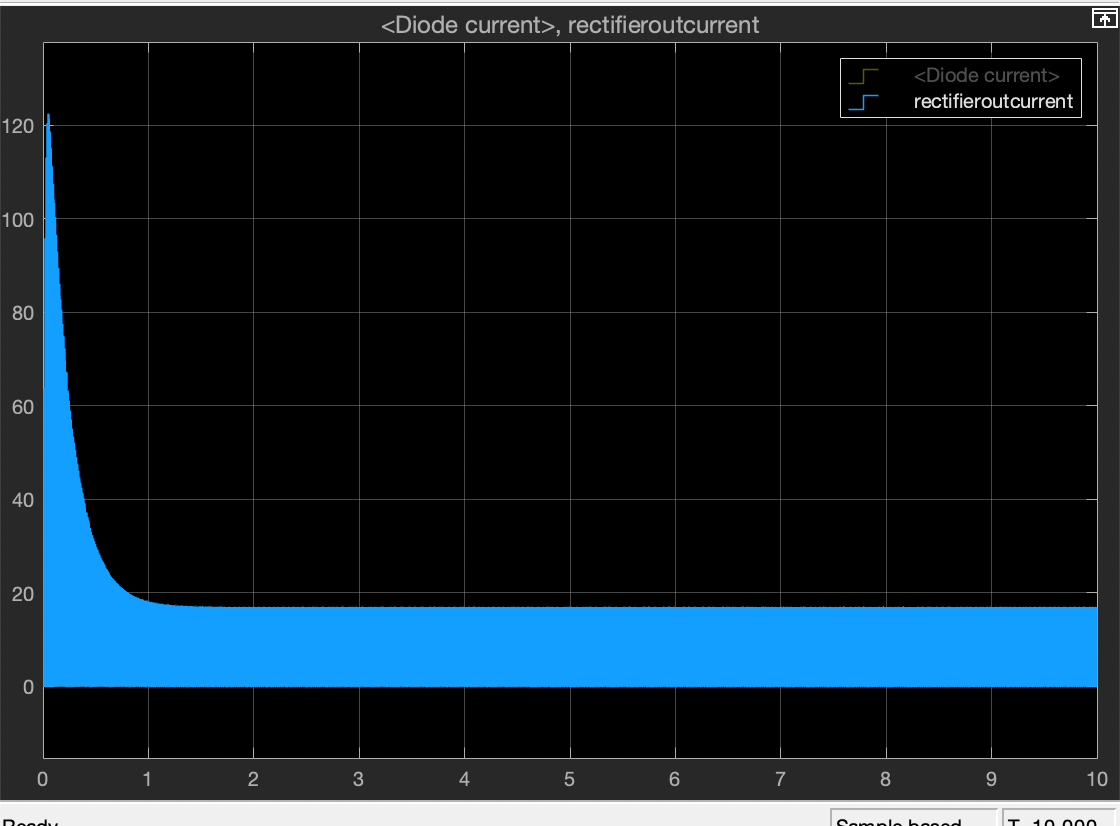
Graphs /0.5DutyCycle/RectifierOutputCurrent.png
