kkaya674/EE463-TermProject/Graphs /0.8DutyCycle, 180VOut/0.8 Duty cycle output for different capacitors/1x270uF_all_withESR.PNG

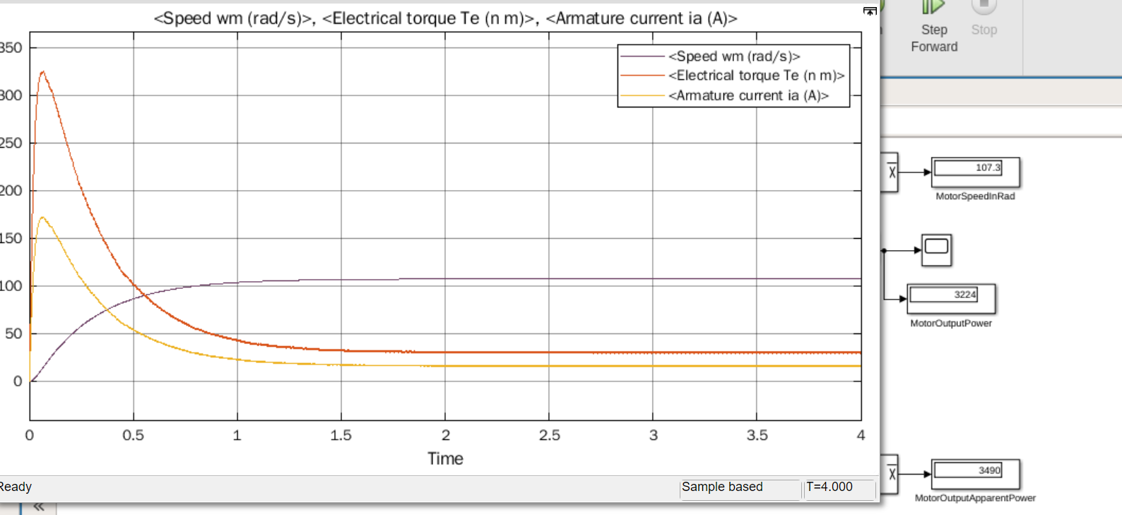
Graphs /0.8DutyCycle, 180VOut/0.8 Duty cycle output for different capacitors/1x270uF_all_withESR.PNG
