kkaya674/EE463-TermProject/Graphs /0.8DutyCycle, 180VOut/0.8 Duty cycle output for different capacitors/complete_nonidealwithdiodes_2.7Vforwardvoltage.PNG

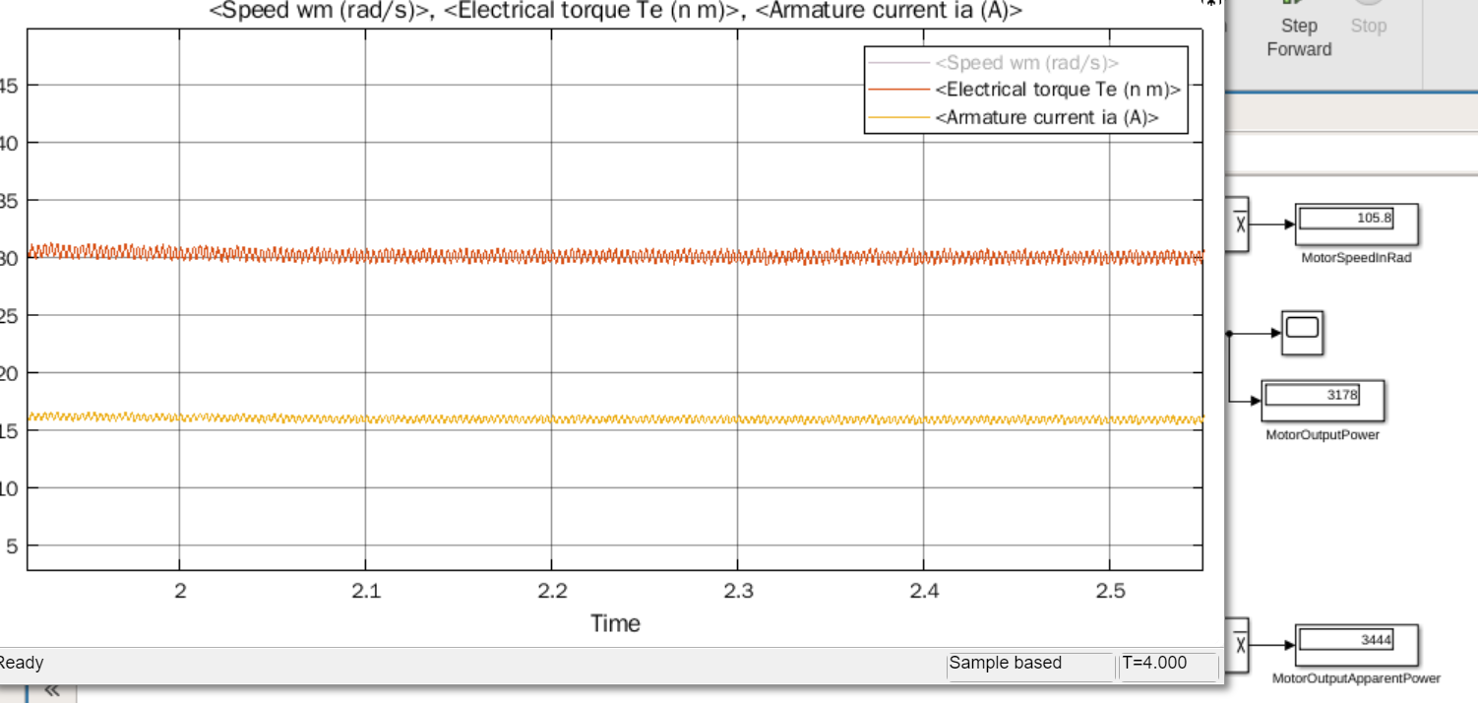
Graphs /0.8DutyCycle, 180VOut/0.8 Duty cycle output for different capacitors/complete_nonidealwithdiodes_2.7Vforwardvoltage.PNG
