kkaya674/EE463-TermProject/Graphs /0.8DutyCycle, 180VOut/IGBTCurrent_MostDetailed.png

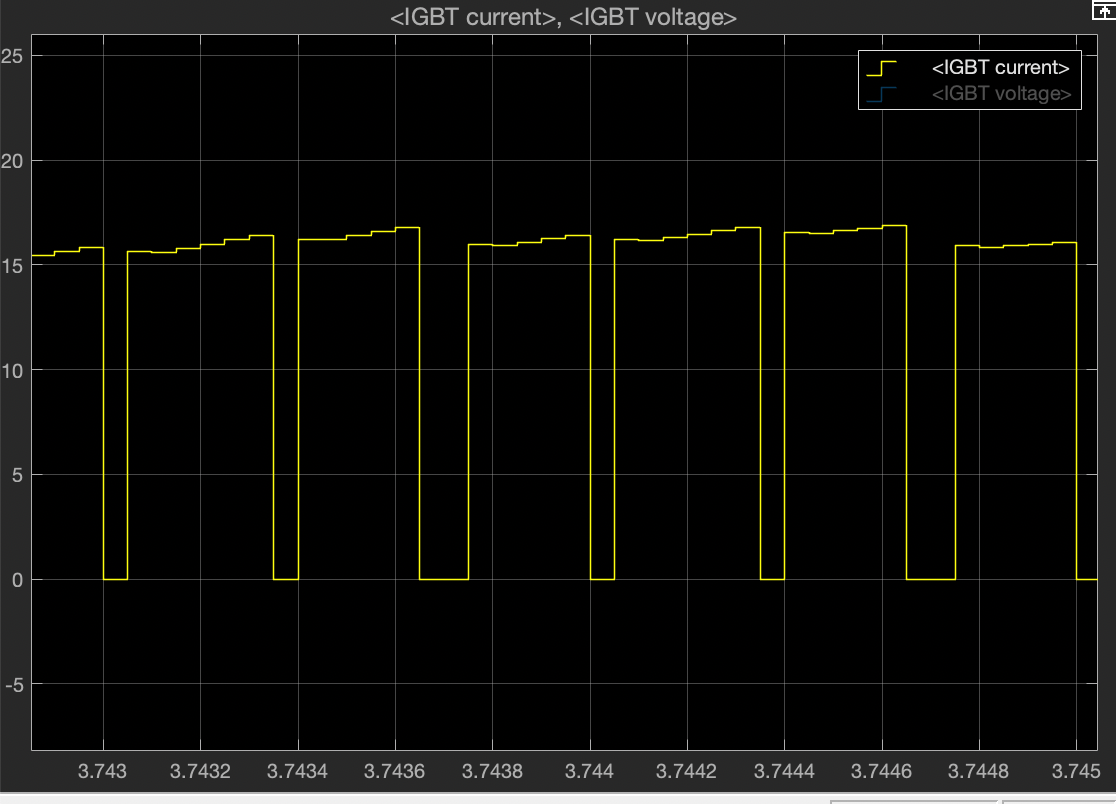
Graphs /0.8DutyCycle, 180VOut/IGBTCurrent_MostDetailed.png
