kkaya674/EE463-TermProject/Graphs /0.8DutyCycle, 180VOut/MotorSpeedInRad.png

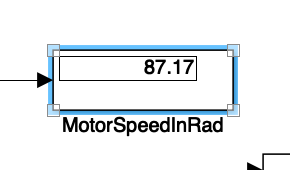
Graphs /0.8DutyCycle, 180VOut/MotorSpeedInRad.png
