kkaya674/EE463-TermProject/Informative Pictures/f2.1_1.png

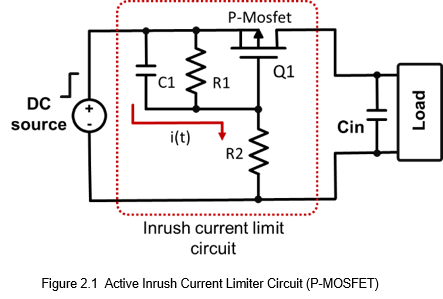
Informative Pictures/f2.1_1.png
