kkaya674/EE463-TermProject/Informative Pictures/Lab Recordings-20220101T191037Z-001/Lab Recordings/20211231_122043.jpg

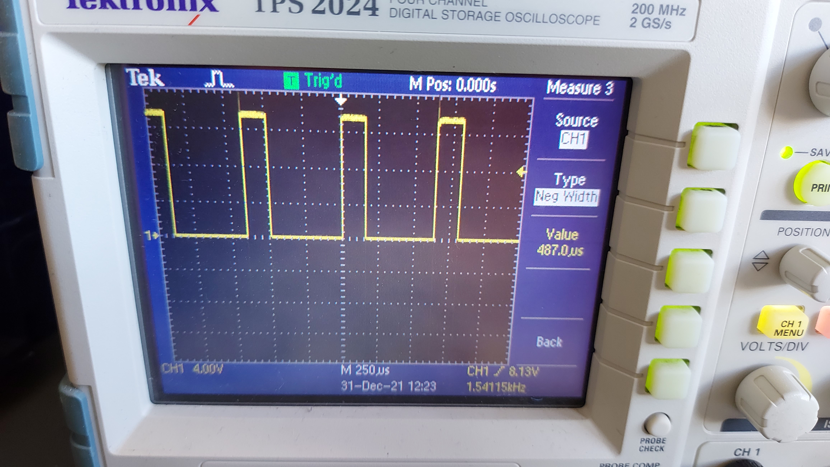
Informative Pictures/Lab Recordings-20220101T191037Z-001/Lab Recordings/20211231_122043.jpg
