kkaya674/EE463-TermProject/Schemes/LtSpice Schemes/Controller and IGBT with gate driver.png

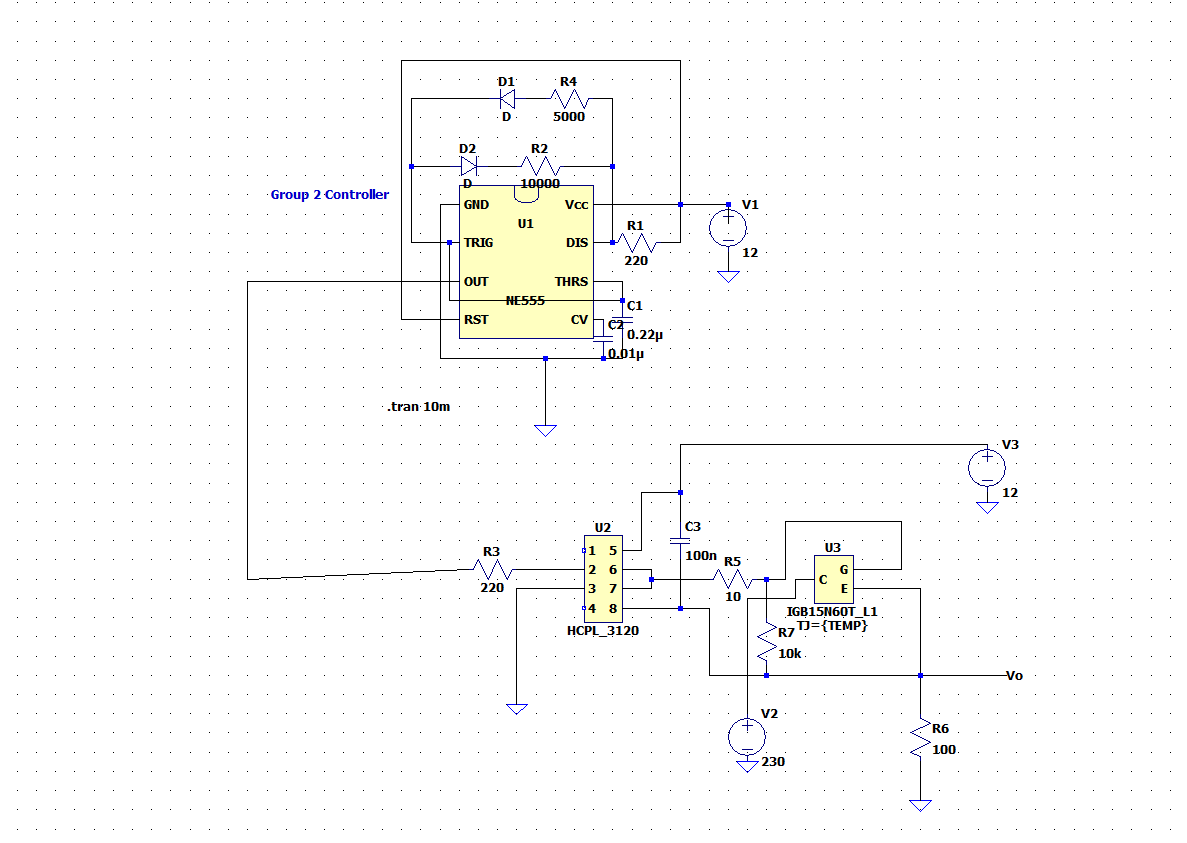
Schemes/LtSpice Schemes/Controller and IGBT with gate driver.png
