kkaya674/EE463-TermProject/Schemes/LtSpice Schemes/Ekran Resmi 2021-12-31 11.41.55.png

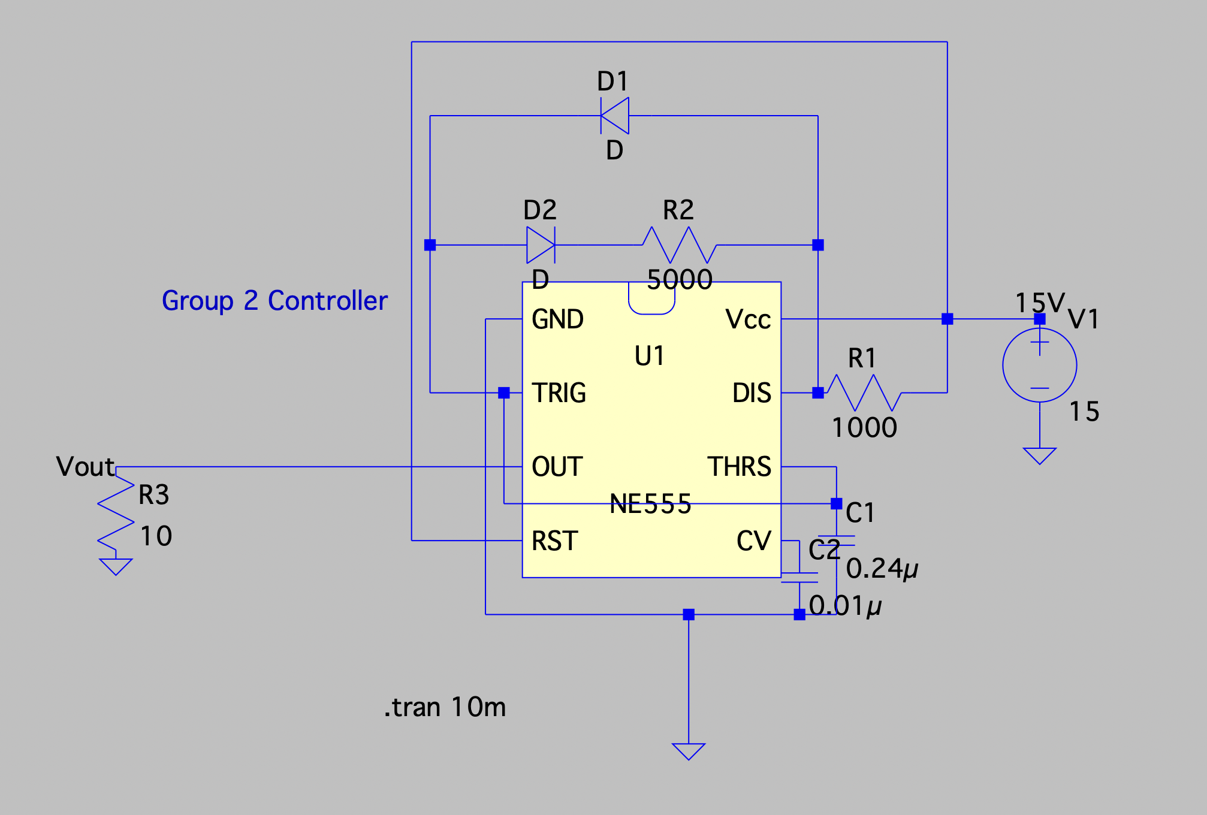
Schemes/LtSpice Schemes/Ekran Resmi 2021-12-31 11.41.55.png
