kkaya674/EE463-TermProject/Schemes/LtSpice Schemes/IGBT gate driver design.jpeg

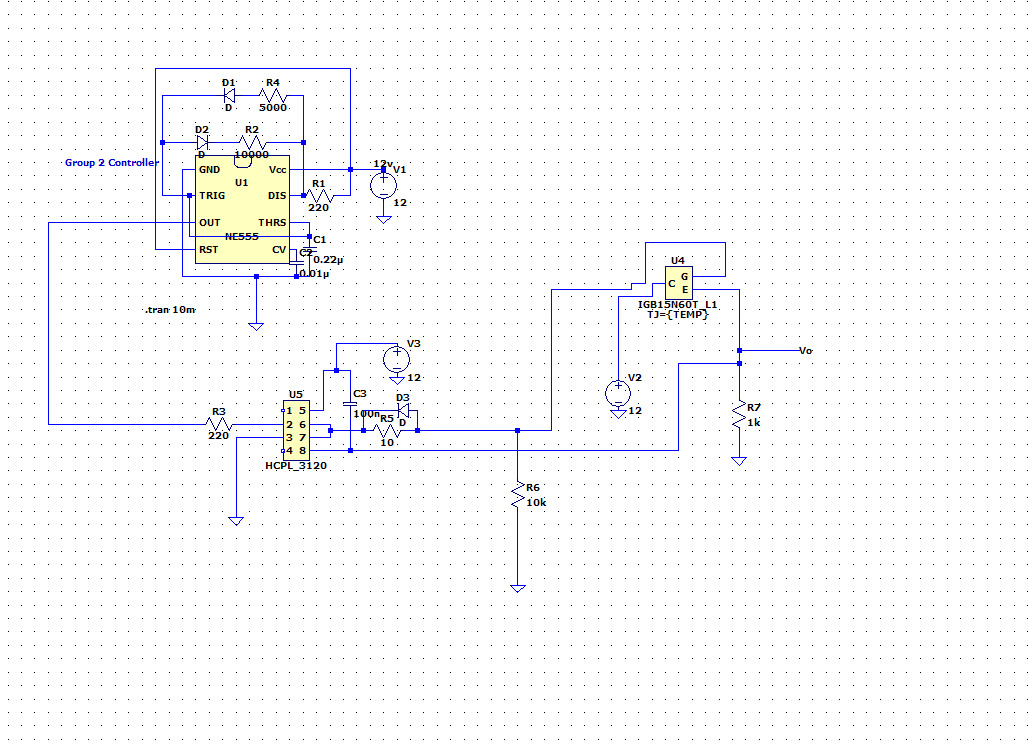
Schemes/LtSpice Schemes/IGBT gate driver design.jpeg
