kkaya674/EE463-TermProject/Schemes/Project_EE463_Project_2022-01-01_18-00-06/project_pcb.png

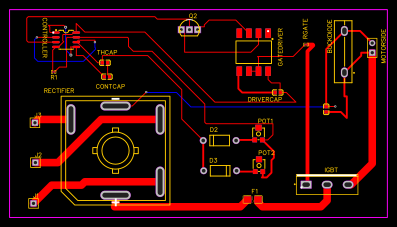
Schemes/Project_EE463_Project_2022-01-01_18-00-06/project_pcb.png
