kkaya674/EE463-TermProject/Schemes/Simulink Schemes/ref_17_duty.tif

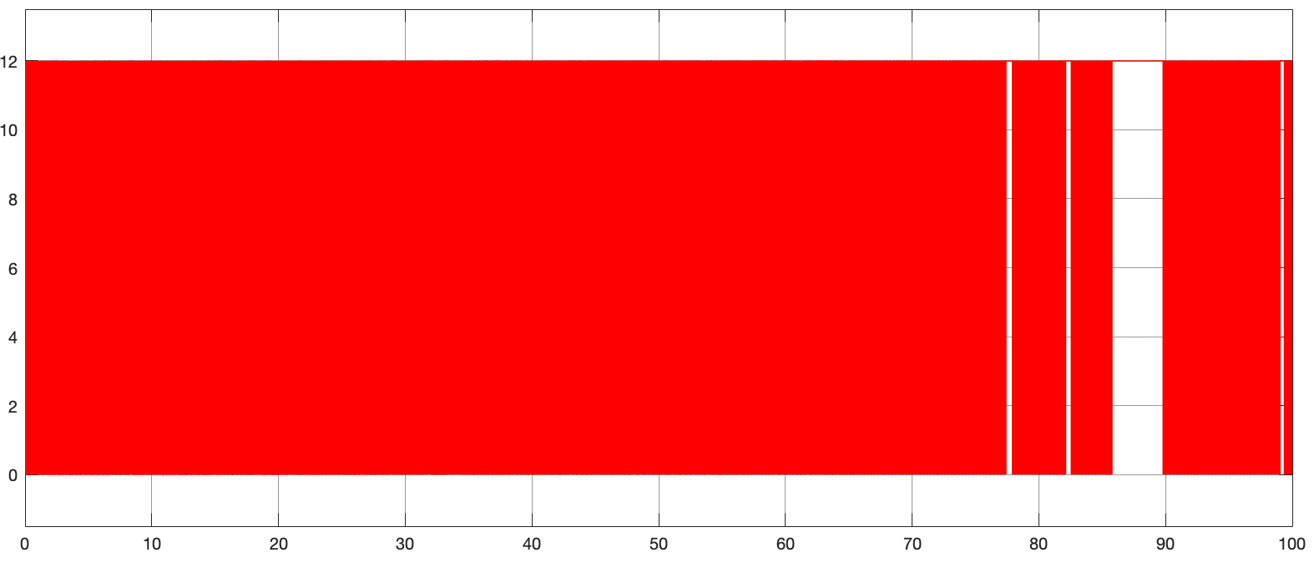
Schemes/Simulink Schemes/ref_17_duty.tif
