kkaya674/EE463-TermProject/Schemes/Simulink Schemes/ref_17_output.tif

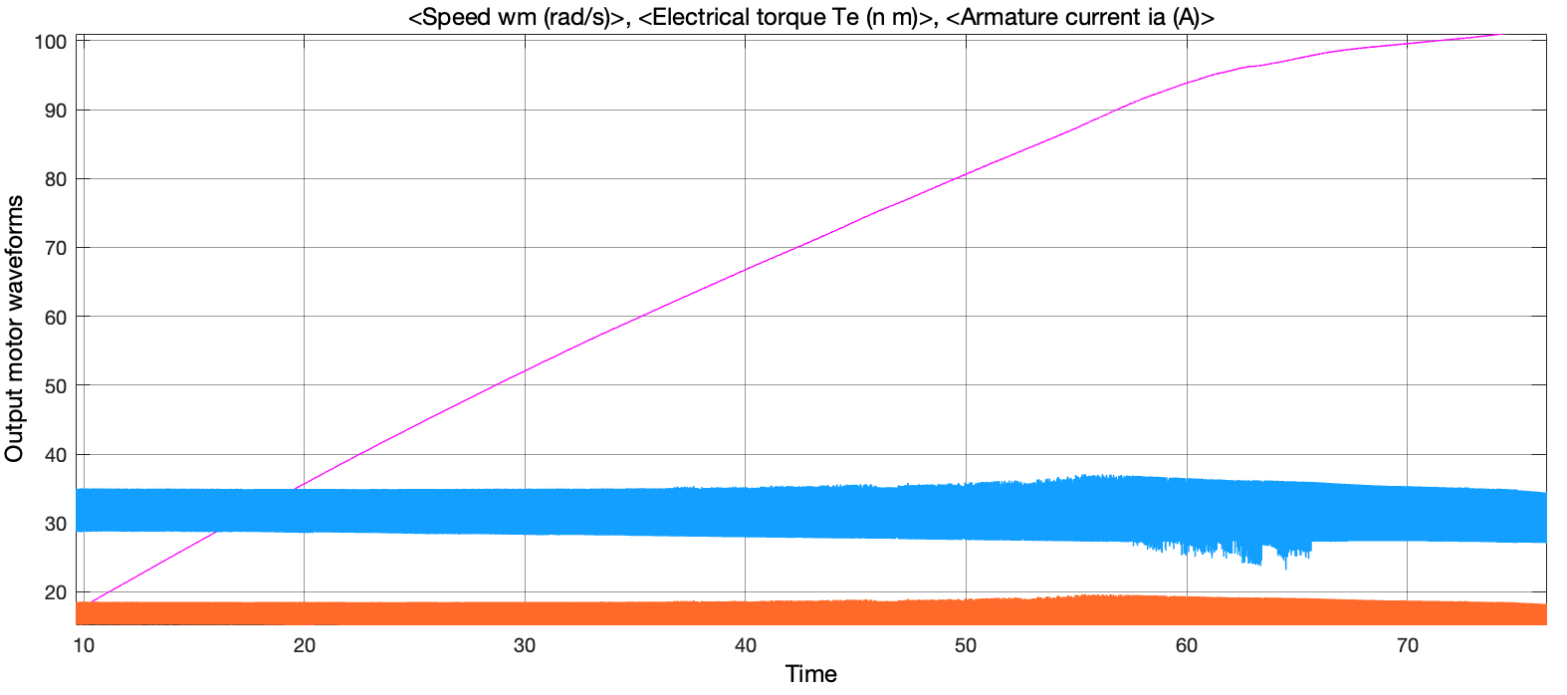
Schemes/Simulink Schemes/ref_17_output.tif
