kkaya674/EE463-TermProject/Schemes/Simulink Schemes/ref_17_output_volt.tif

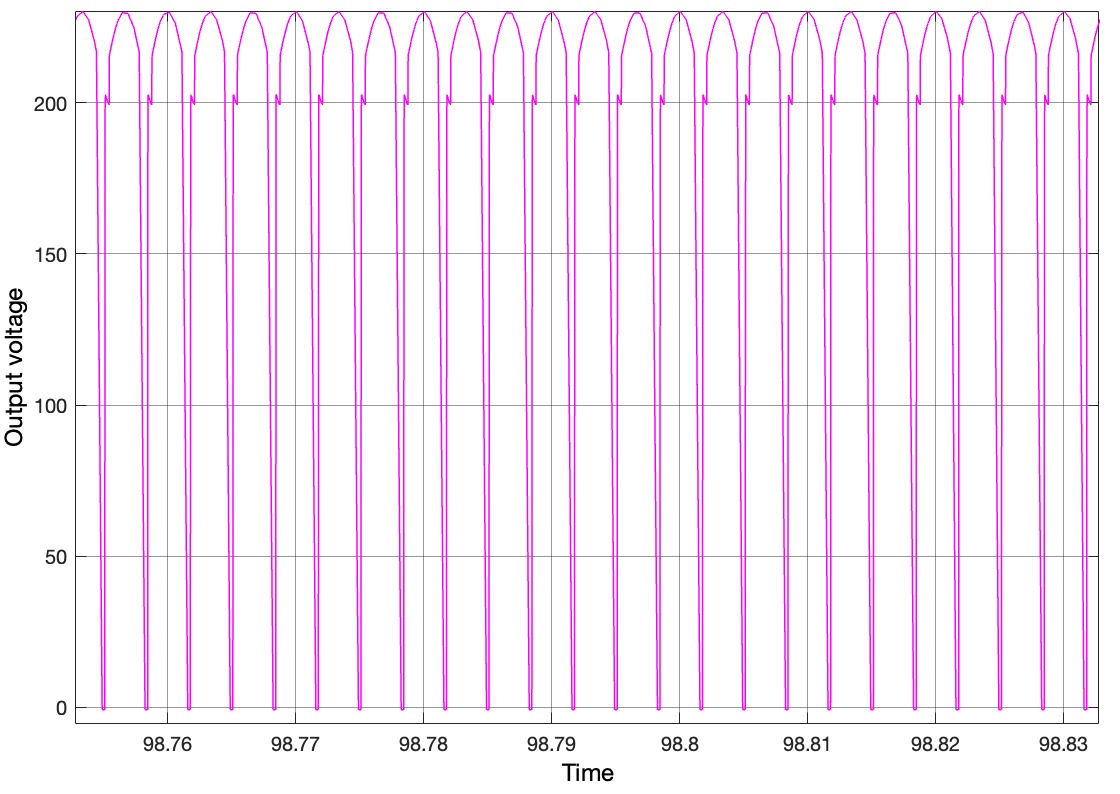
Schemes/Simulink Schemes/ref_17_output_volt.tif
