kkaya674/EE463-TermProject/Cost Analysis.pdf

Tablo 1

Ürün | Adet | Fiyat
IGBT | 1 | 68,26
390uF Cap | 1 | 40
Rectifier | 1 | 38,5
DSEI30 Diyot | 1 | 27
TLP250 | 1 | 26,03
Fan | 1 | 21,84
Heatsink | 3 | 21
13*25 Stripboard | 1 | 15,78
Jak | 5 | 7,77
30A Seramik Sigorta | 1 | 2,66
Sigorta Yuvası | 1 | 2,63
10k Pot | 1 | 2
1k Pot | 1 | 2
555 Timer | 1 | 1,82
0.22uF Cap | 1 | 1,13
Thermal Pad | 1 | 0,47
1N4007 Diyot | 2 | 0,42
Pin Soket | 1 | 0,34
Çeşitli Dirençler | 6 | 0,276
100nF Seramik Cap | 2 | 0,138
Toplam | | 280,064

IGBT

390uF Cap

Rectifier

DSEI30 Diyot

TLP250

Fan

Heatsink

13*25 Stripboard

Jak

30A Seramik Sigorta

Sigorta Yuvası

10k Pot

1k Pot

555 Timer

0.22uF Cap

Thermal Pad

1N4007 Diyot

Pin Soket

Çeşitli Dirençler

100nF Seramik Cap

0 | 17,5 | 35 | 52,5 | 70

Fiyat

1
