kkaya674/EE463-TermProject/CostAnalysis Raw.jpeg

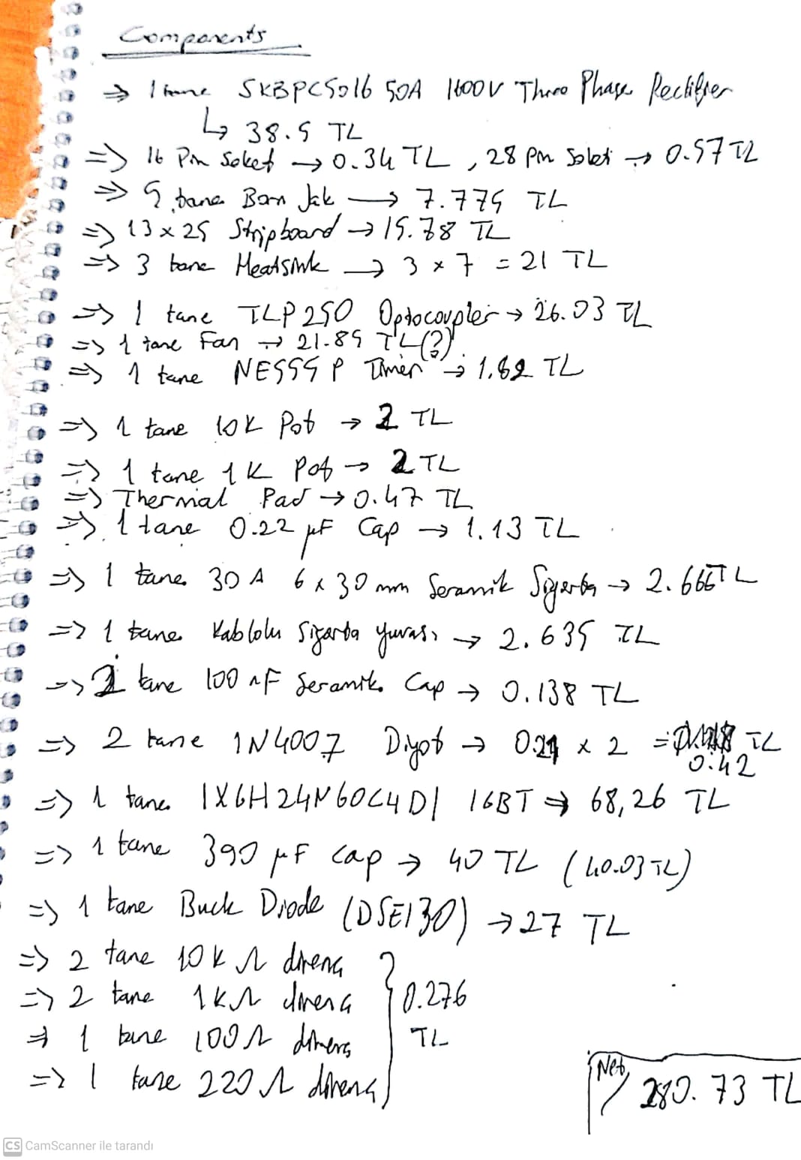
CostAnalysis Raw.jpeg
