kkaya674/EE463-TermProject/(commit log)

2021-12-23 3bridgeRectifier & BuckConverter is connected a DC motor.
2021-12-25 Photos About Controller are added. ( Some formulations and circuit scheme etc)
2021-12-25 Possible components
    Datasheets for diode selection
2021-12-27 30A SonicFast Diode datasheet was added
    This one can be the most strongly choice, by considering the market
2021-12-27 capacitor weblinks were added
    possible filter capacitor market links
2021-12-27 Output data for different capacitors
    At 0.2 duty cycle, output data for different capacitors were recorded
2021-12-27 Output data for different capacitors
    At 0.8 duty cycle output data for different capacitors were recorded
2021-12-28 additional diode datasheets
2021-12-28 Some parameters of diodes are added
2021-12-30 Analytical calculations
    Analytical calculations were added for the rectifier and buck converter design.
2021-12-31 GateDriver Circuit is added
2021-12-31 Datasheet of gate driver
    Datasheet for TLP250 Gate Driver was added
2021-12-31 screenshot of IGBT with gate driver(LTspice)
2021-12-31 additional gate drivers
2022-01-01 PCB model was designed
    Primary PCB design of overall motor drive was constructed.
2022-01-01 Circuit model for PCB in png format
    first designed circuit of considered dc motor drive
2022-01-01 updated models for pcb
    bjt model was changed
2022-01-01 Prototype work has begun
    Measurements taken at the lab were added.
2022-01-01 design of IGBT gate driver and some plots
2022-01-02 Thermal Analysis for Diodes
2022-01-02 Thermal analysis for IGBT
    Thermal analysis and circuit design of IGBT were added.
2022-01-02 Thermal analysis for simulation report
    Combined thermal analysis and calculations were added for IGBT, rectifier and buck diode.
2022-01-02 Gate Driver Part is updated (By Şevval)
2022-01-02 Report is updated (Withoud rectifier output voltage and current values)
2022-01-02 Another possible gate driver
    Datasheet for HCPL-3120 was added.
2022-01-02 Possible heatsink
    Datasheet of the heatsink in the lab was added
2022-02-07 Last version of expected PCB design
    It was not implemented. Nevertheless, what has overall been done was added.
